delyamio/Avior/Алгоритм/use case общее.pdf

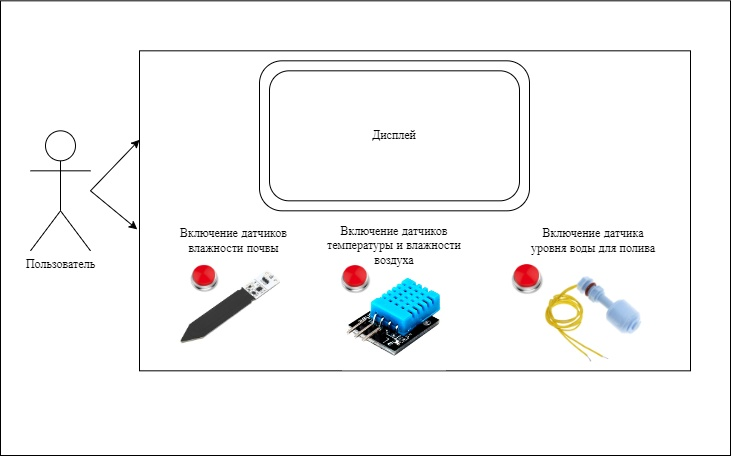
[picture p1: page 1]
