delyamio/Avior/Алгоритм/use case.pdf

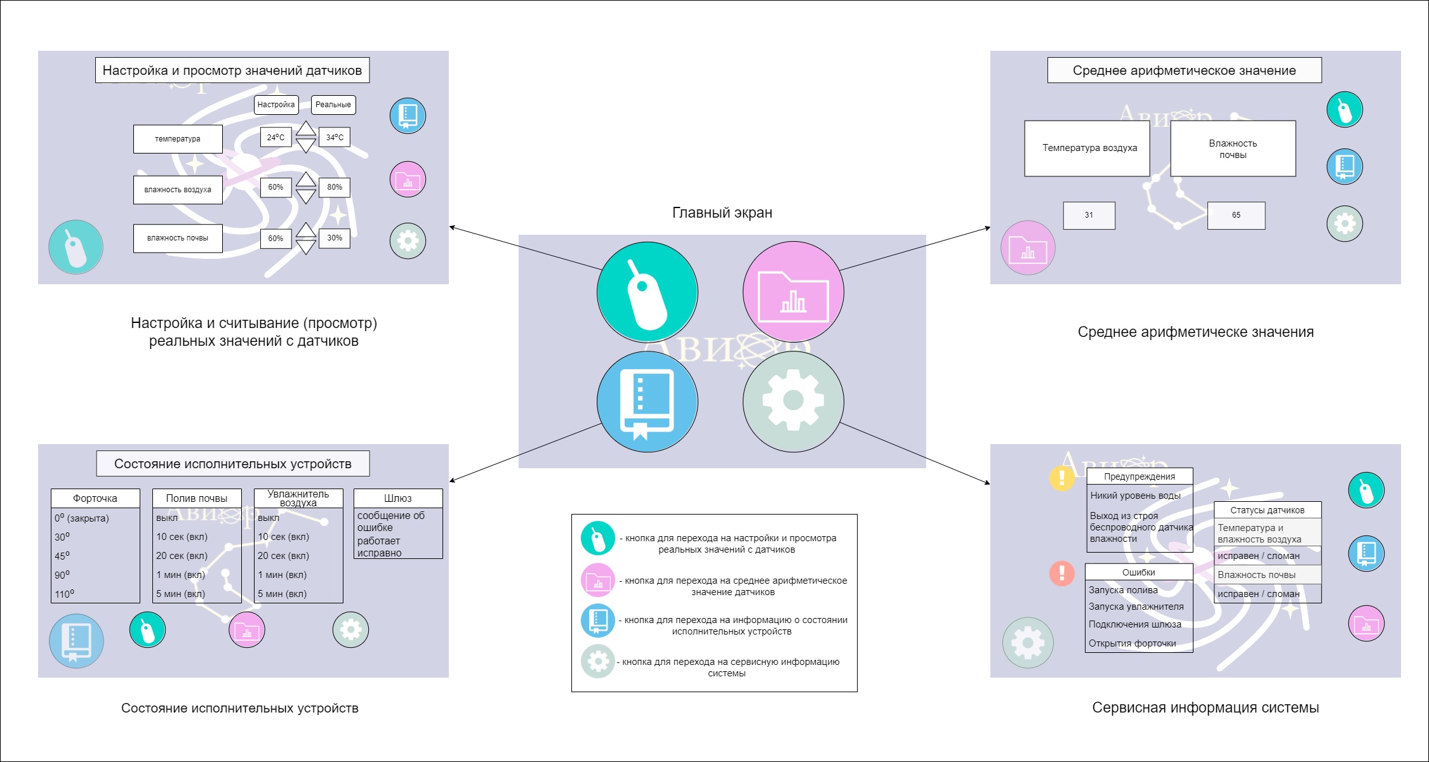
[picture p2: page 1]
