delyamio/Avior/Алгоритм/главный экран2.pdf

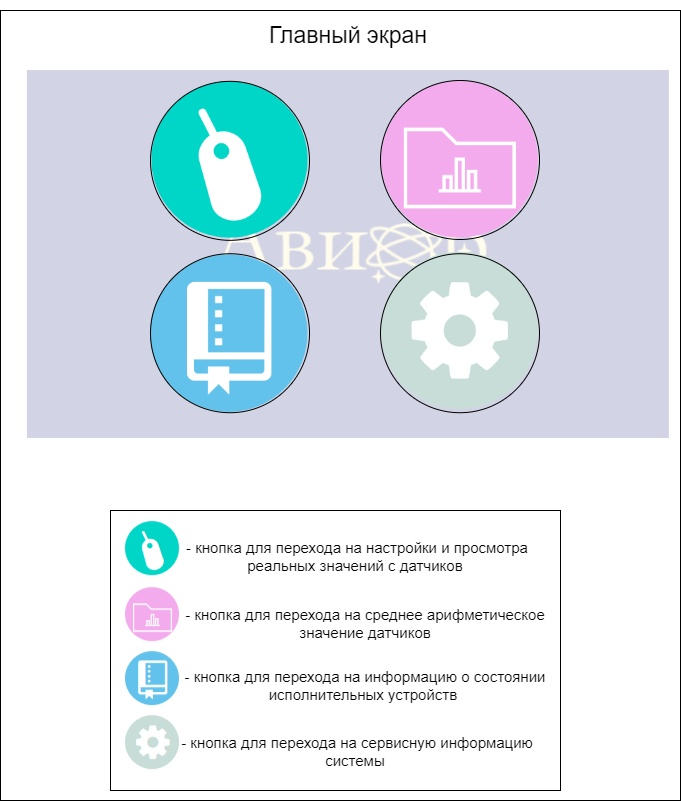
[picture p3: page 1]
