delyamio/Avior/Алгоритм/настройка значений.pdf

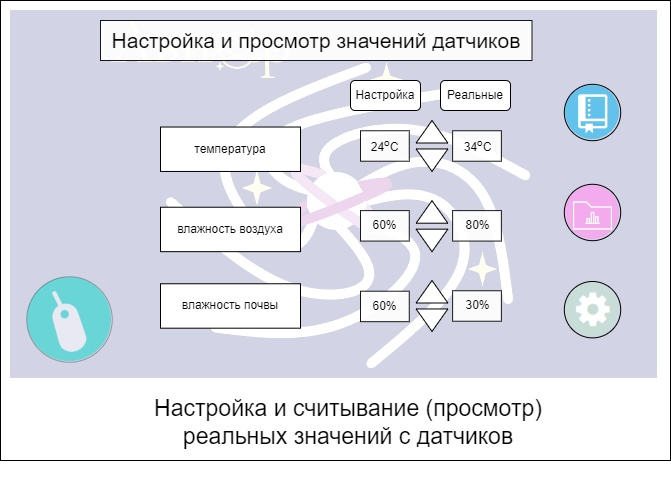
[picture p4: page 1]
