delyamio/Avior/Алгоритм/сервисная информайия.pdf

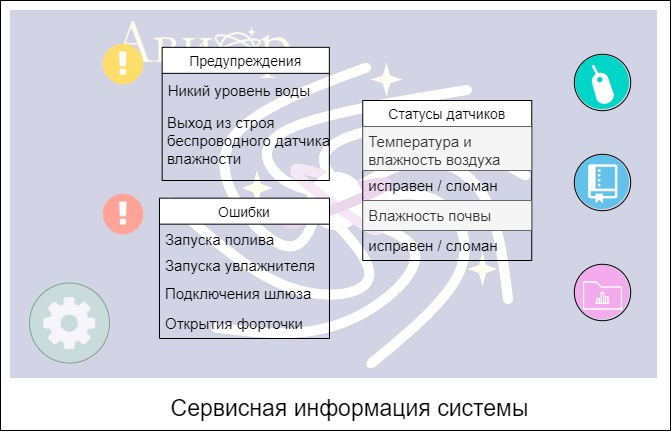
[picture p5: page 1]
