delyamio/Avior/Алгоритм/Состояние исполнительных устройств.pdf

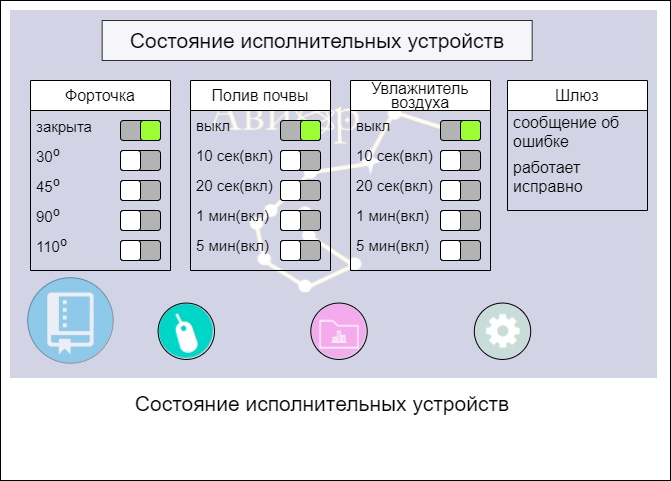
[picture p6: page 1]
