delyamio/Avior/Алгоритм/среднее арифметическое.pdf

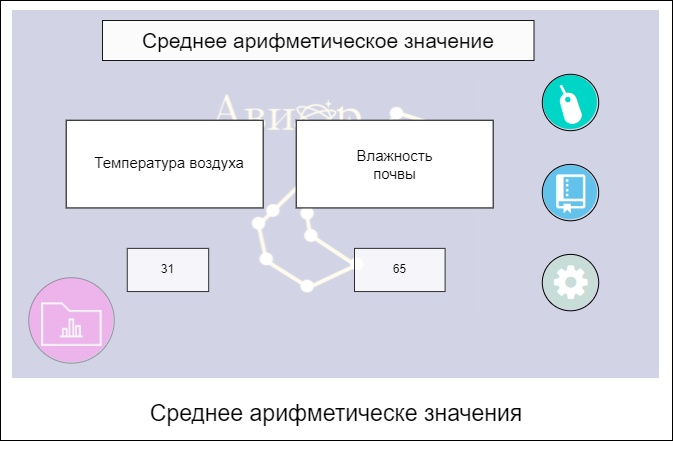
[picture p7: page 1]
