delyamio/Avior/Электроника/Монтажная схема - Механизм для форточки.pdf

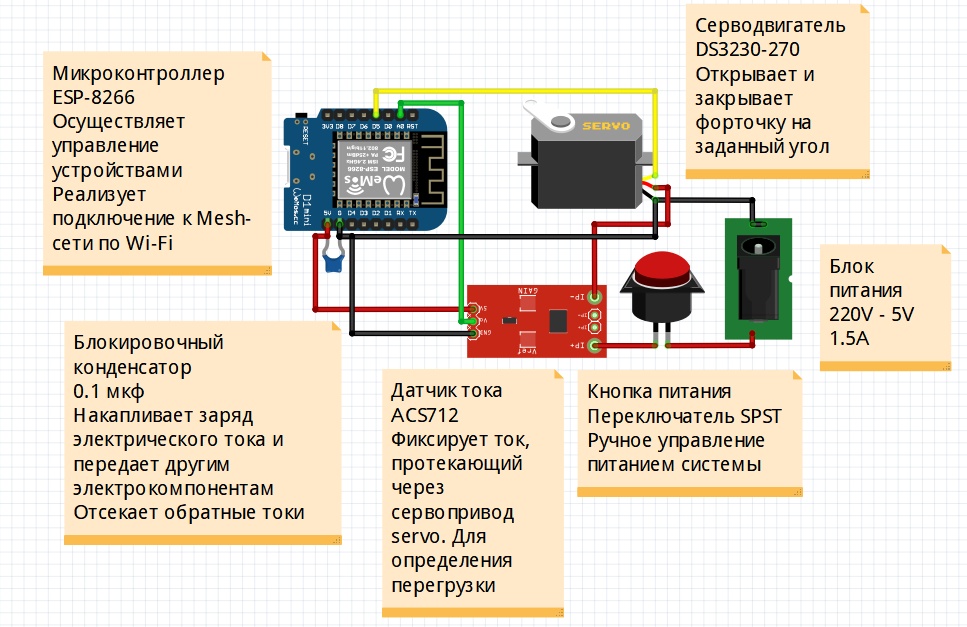
[picture p8: page 1]
