delyamio/Avior/Электроника/Монтажная схема - Система климатических датчиков.pdf

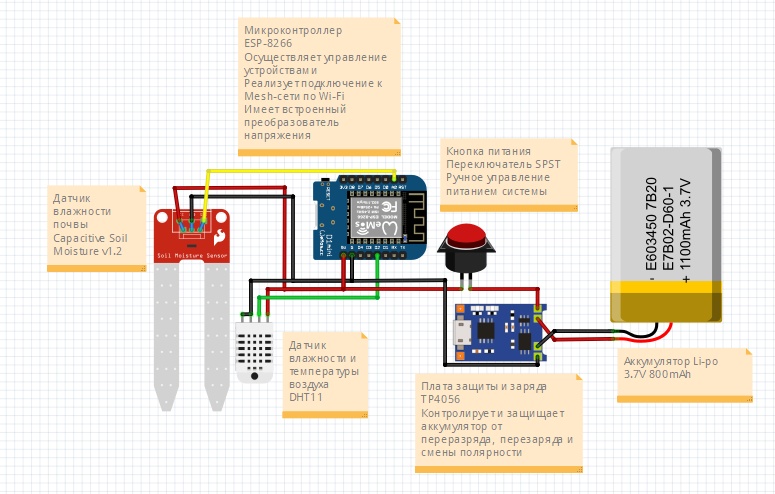
[picture p9: page 1]
