delyamio/Avior/Электроника/Монтажная схема - Система полива и увлажнения.pdf

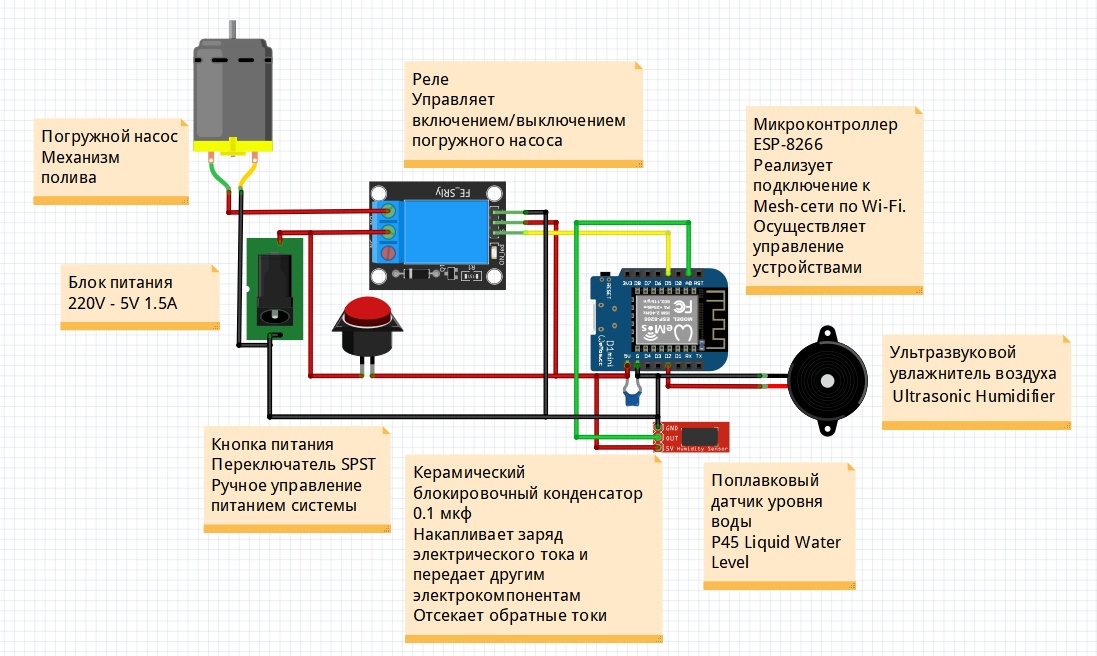
[picture p10: page 1]
