delyamio/Avior/Электроника/Монтажная схема - Узел агрегации.pdf

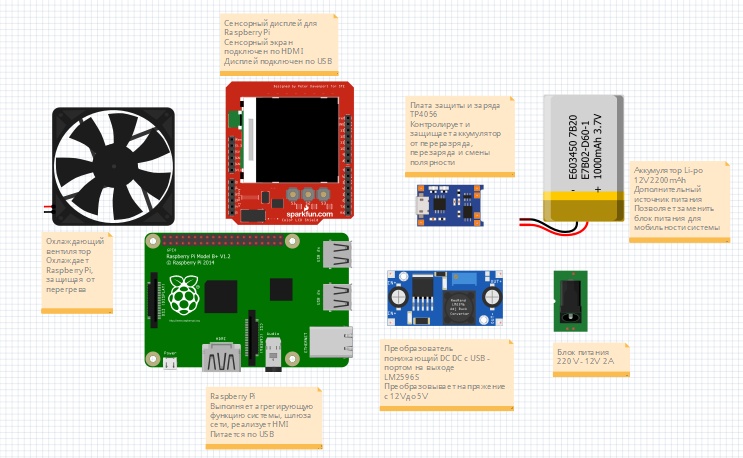
[picture p11: page 1]
