delyamio/Avior/Электроника/Принципиальная схема - Механизм для форточки.pdf

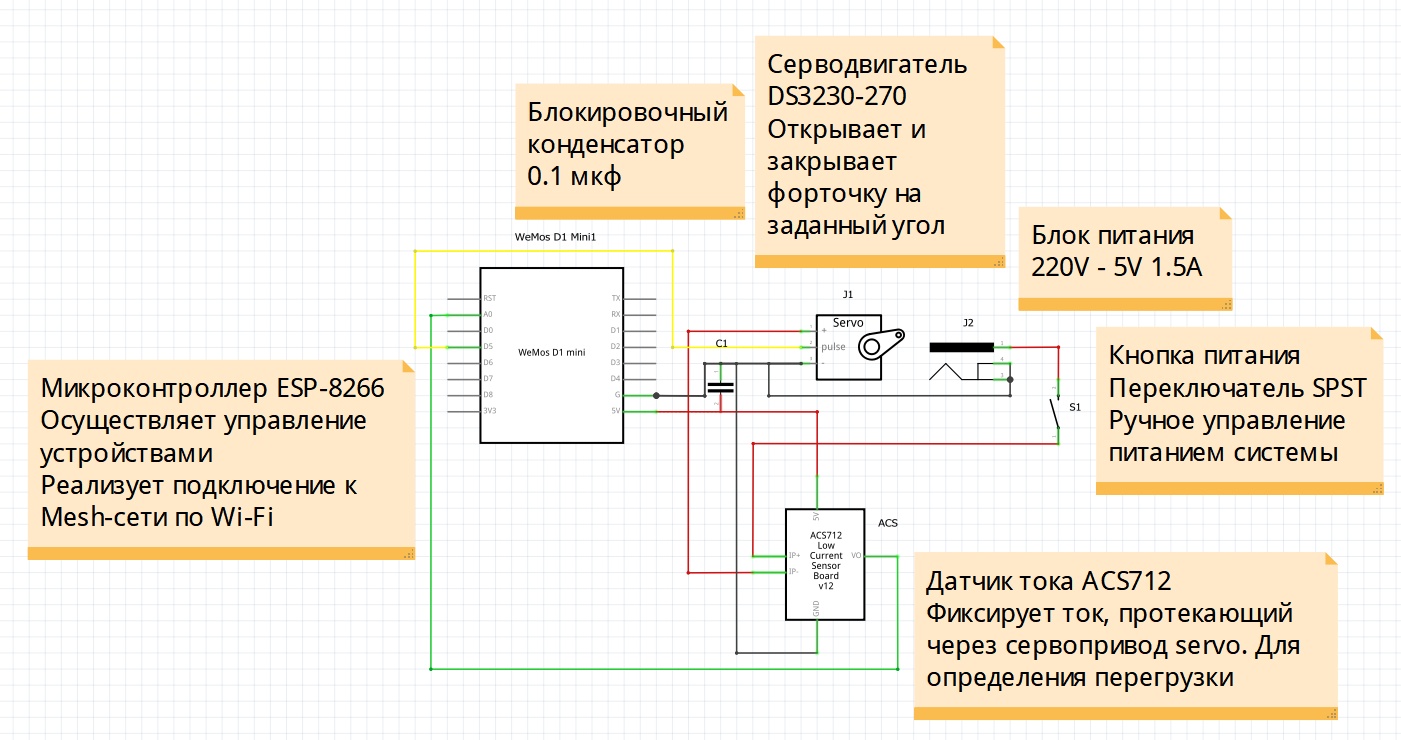
[picture p12: page 1]
