delyamio/Avior/Электроника/Принципиальная схема - Система климатических датчиков.pdf

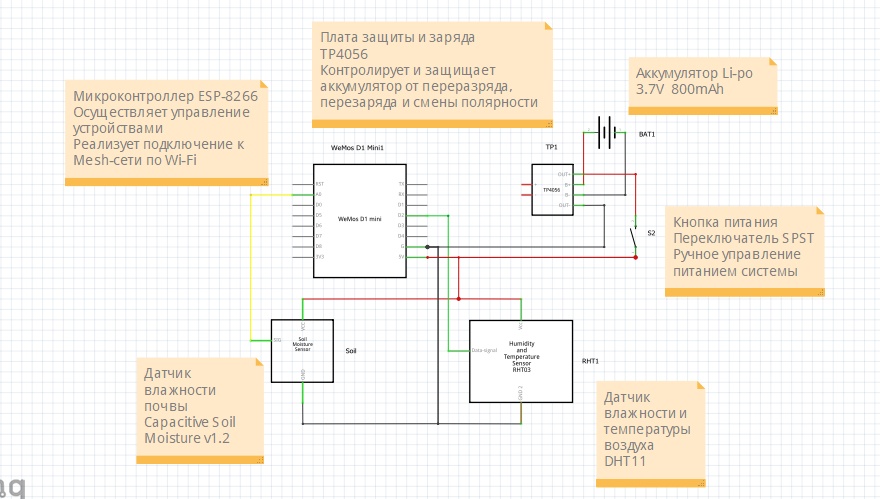
[picture p13: page 1]
