delyamio/Avior/Электроника/Принципиальная схема - Система полива и увлажнения.pdf

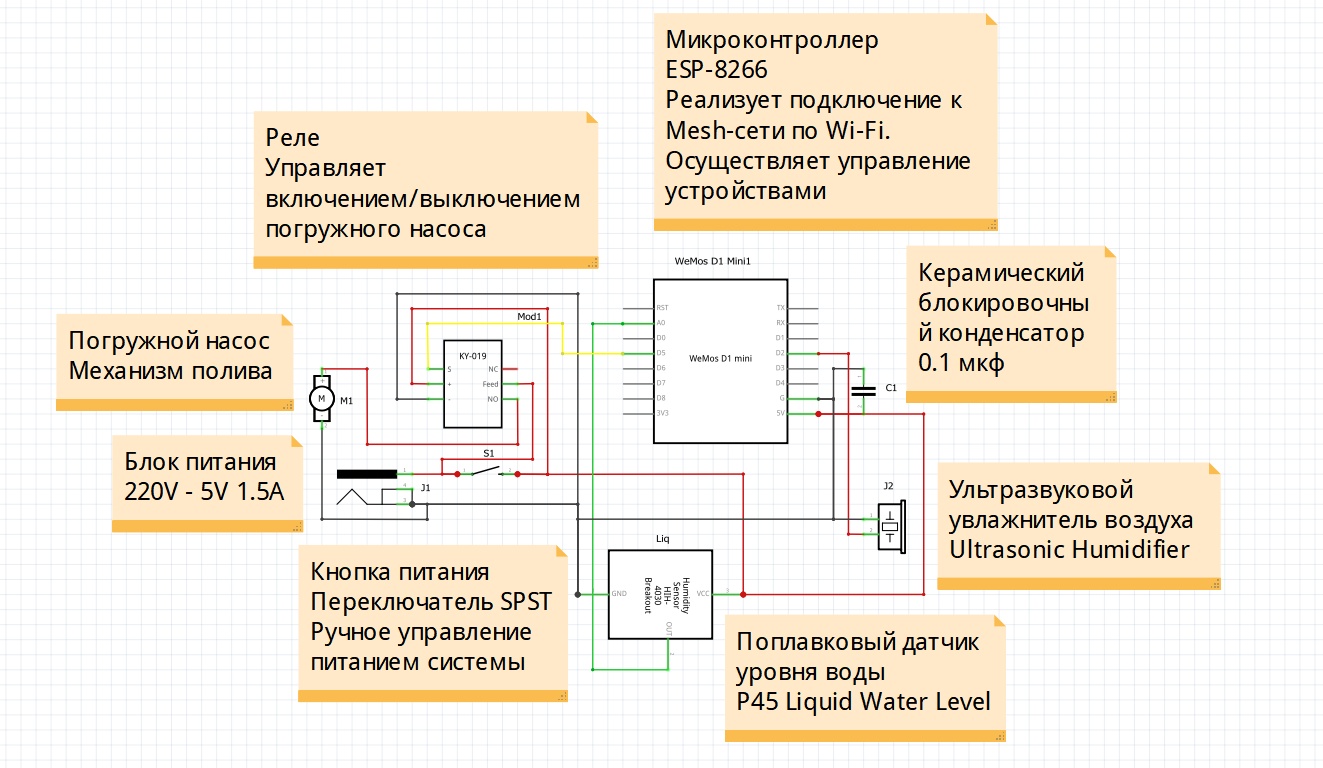
[picture p14: page 1]
