delyamio/Avior/Электроника/Принципиальная схема - Узел агрегации.pdf

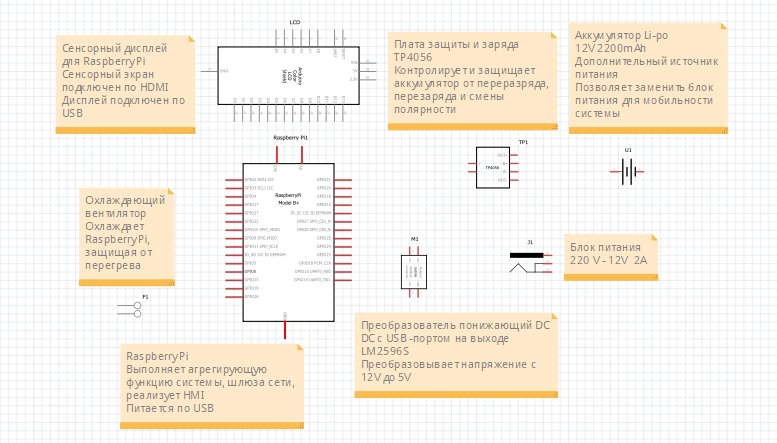
[picture p15: page 1]
