delyamio/Avior/3D модели/рендеринг/датчики воздух почва/датчики воздух почва 2.png

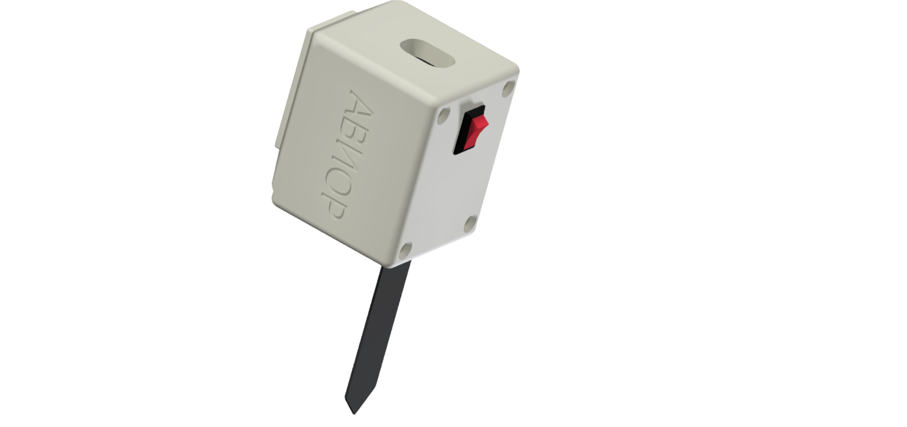
3D модели/рендеринг/датчики воздух почва/датчики воздух почва 2.png
