delyamio/Avior/3D модели/рендеринг/датчики воздух почва/датчики воздух почва.png

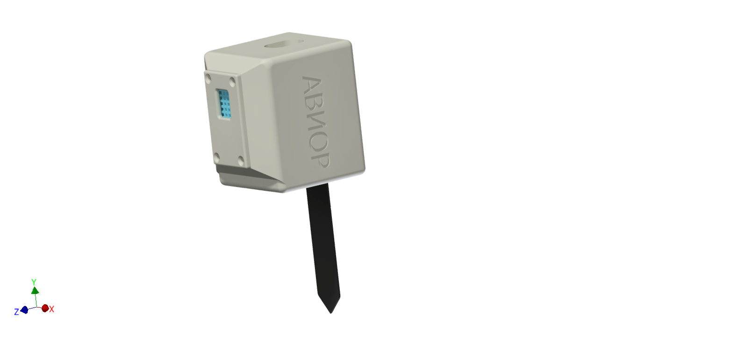
3D модели/рендеринг/датчики воздух почва/датчики воздух почва.png
