delyamio/Avior/3D модели/рендеринг/датчики воздух почва/датчики.png

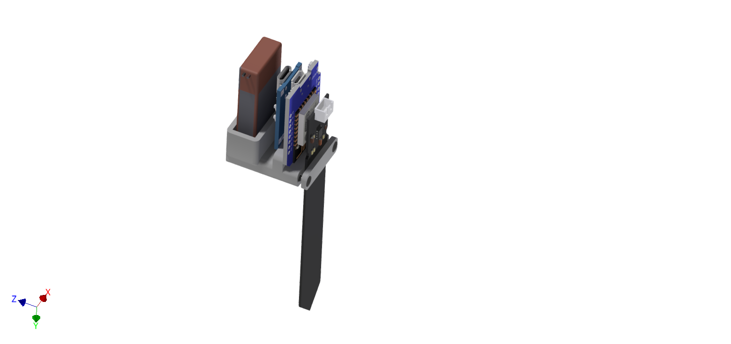
3D модели/рендеринг/датчики воздух почва/датчики.png
