delyamio/Avior/3D модели/рендеринг/датчики воздух почва/корпус датчики1.png

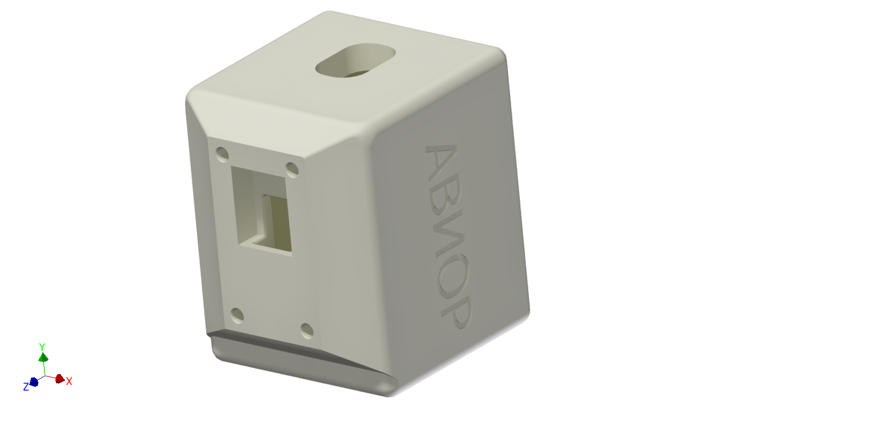
3D модели/рендеринг/датчики воздух почва/корпус датчики1.png
