delyamio/Avior/3D модели/рендеринг/датчики воздух почва/корпус датчики 2.png

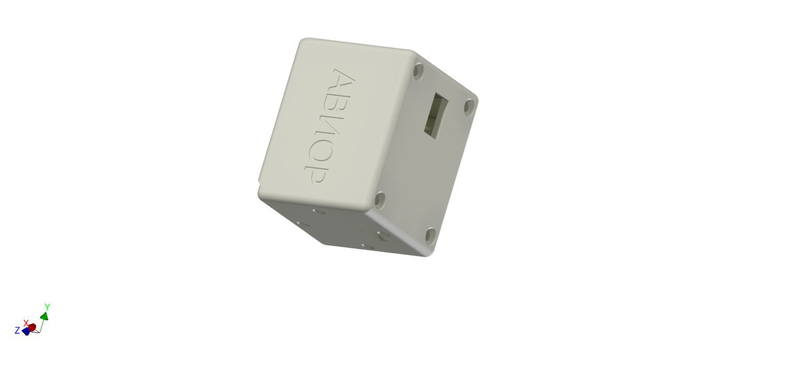
3D модели/рендеринг/датчики воздух почва/корпус датчики 2.png
