delyamio/Avior/3D модели/рендеринг/Дисплей/компоновка корпус дисплей.png

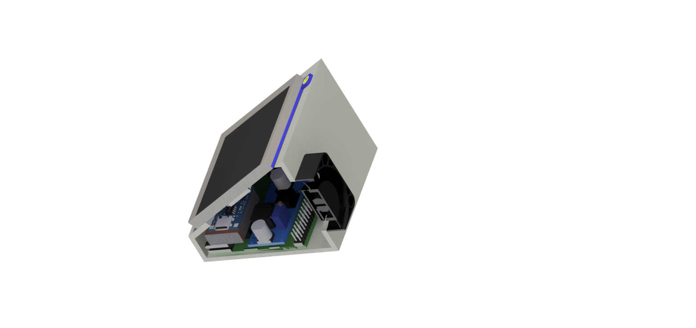
3D модели/рендеринг/Дисплей/компоновка корпус дисплей.png
