delyamio/Avior/3D модели/рендеринг/Дисплей/корпус дисплей.png

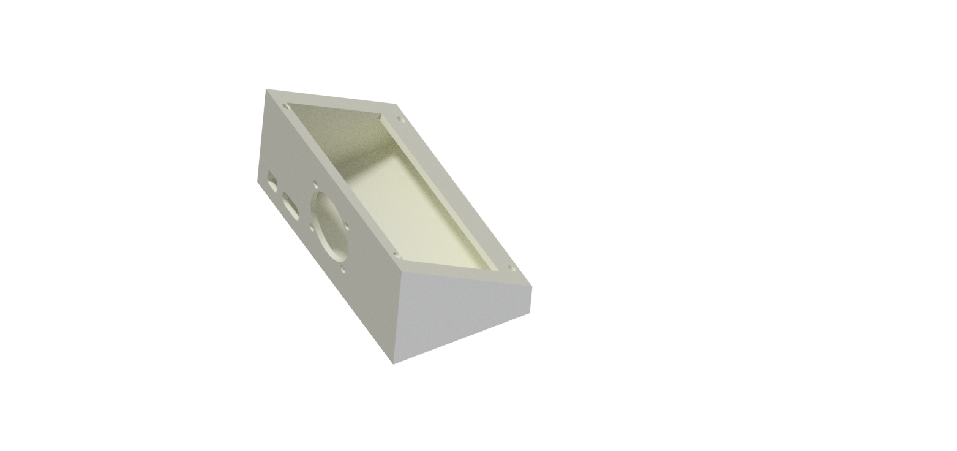
3D модели/рендеринг/Дисплей/корпус дисплей.png
