delyamio/Avior/3D модели/рендеринг/емкость/держатель.png

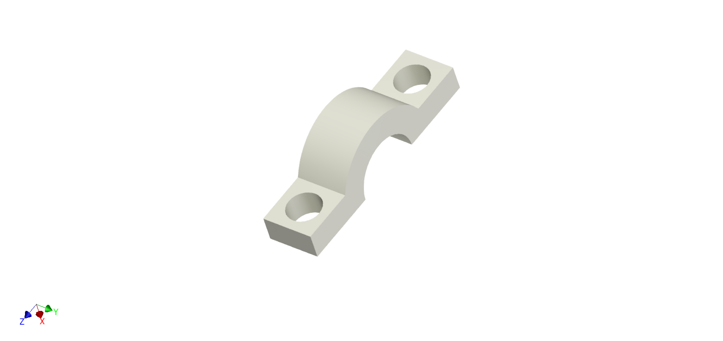
3D модели/рендеринг/емкость/держатель.png
