delyamio/Avior/3D модели/рендеринг/емкость/компоновка емкость.png

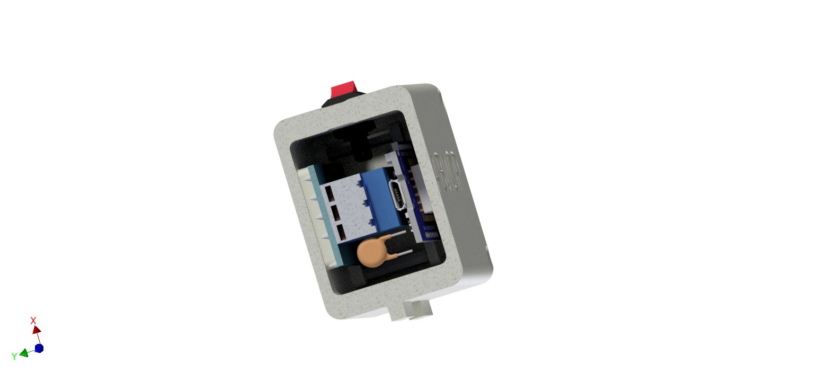
3D модели/рендеринг/емкость/компоновка емкость.png
