delyamio/Avior/3D модели/рендеринг/емкость/корпус емкость.png

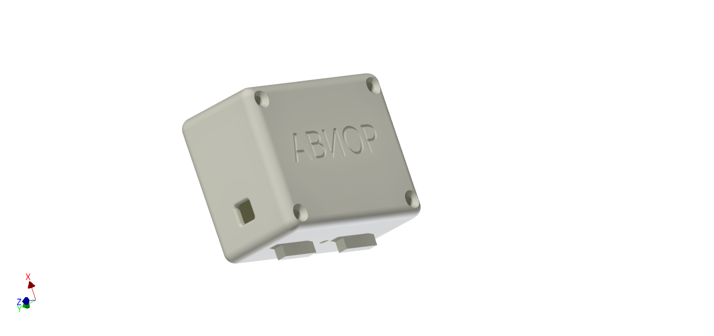
3D модели/рендеринг/емкость/корпус емкость.png
