delyamio/Avior/3D модели/рендеринг/емкость/соединитель 1.png

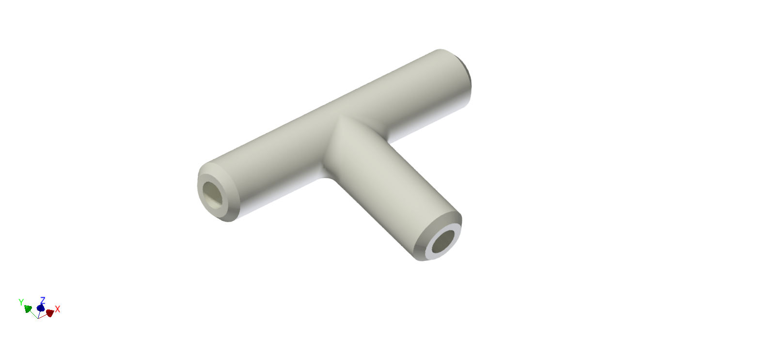
3D модели/рендеринг/емкость/соединитель 1.png
