delyamio/Avior/3D модели/рендеринг/емкость/сосуд.png

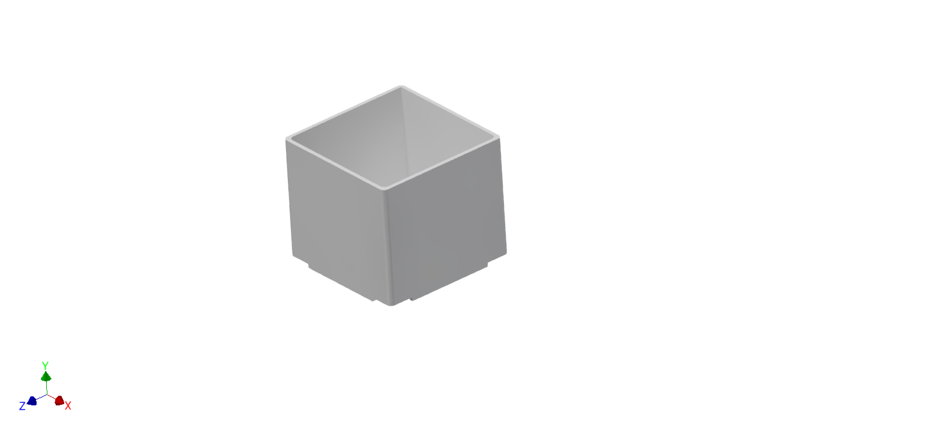
3D модели/рендеринг/емкость/сосуд.png
