delyamio/Avior/3D модели/рендеринг/емкость/труба 3.png

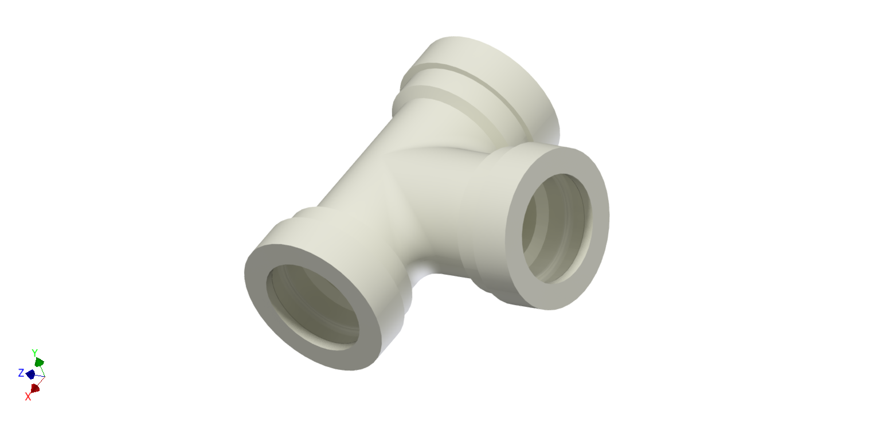
3D модели/рендеринг/емкость/труба 3.png
