delyamio/Avior/3D модели/рендеринг/емкость/УвлажнительНовый.png

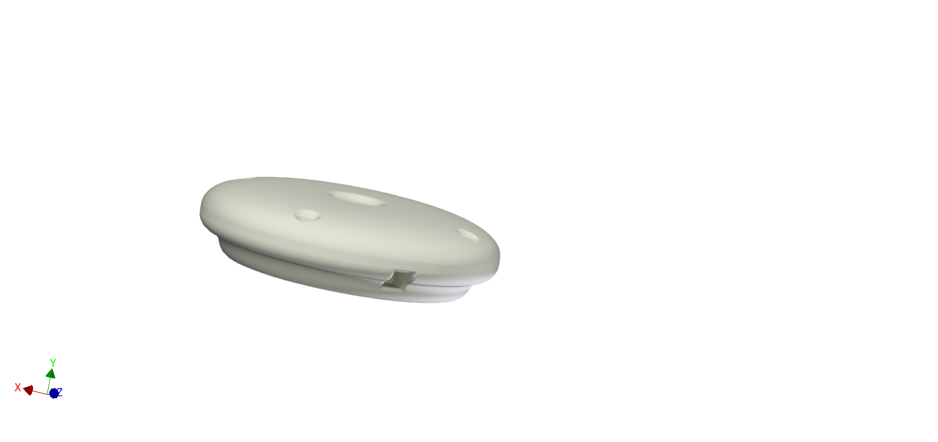
3D модели/рендеринг/емкость/УвлажнительНовый.png
