delyamio/Avior/3D модели/рендеринг/основание/основание.png

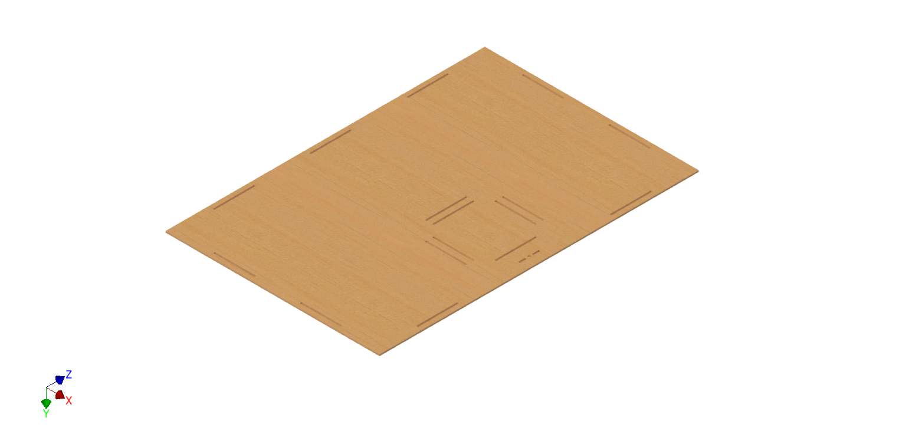
3D модели/рендеринг/основание/основание.png
