delyamio/Avior/3D модели/рендеринг/основание/сборка основание.png

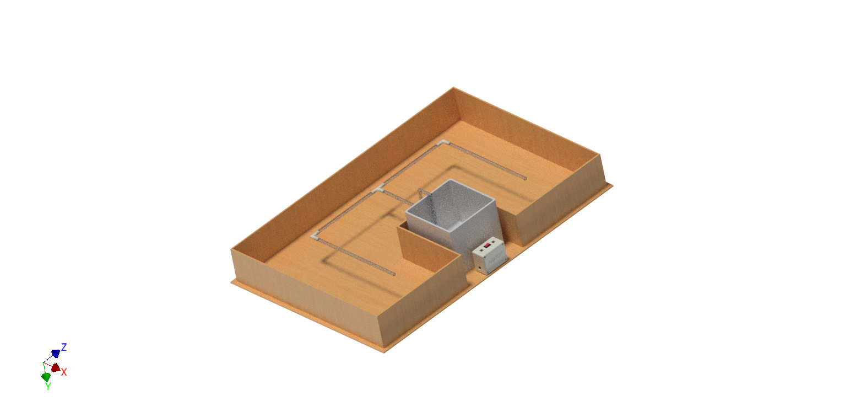
3D модели/рендеринг/основание/сборка основание.png
