delyamio/Avior/3D модели/рендеринг/основание/стенка.png

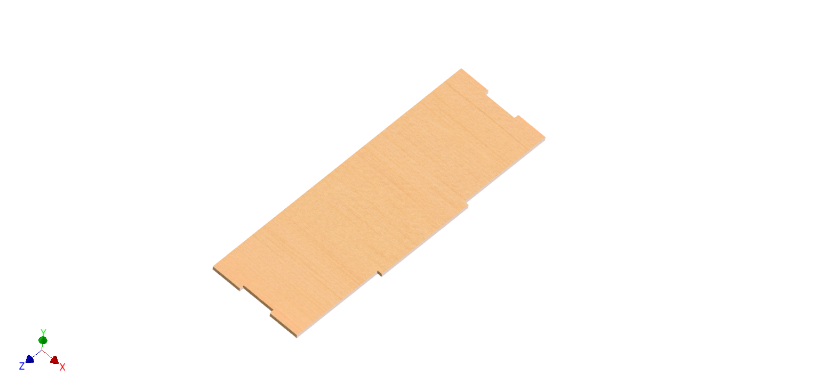
3D модели/рендеринг/основание/стенка.png
