delyamio/Avior/3D модели/рендеринг/финальная сборка1.png

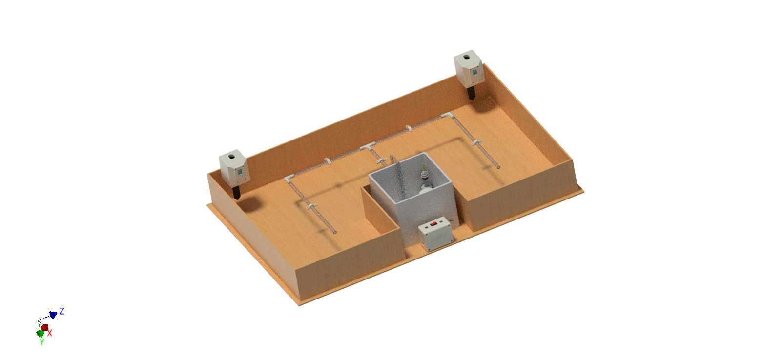
3D модели/рендеринг/финальная сборка1.png
