delyamio/Avior/3D модели/рендеринг/форточка/Кинематика.png

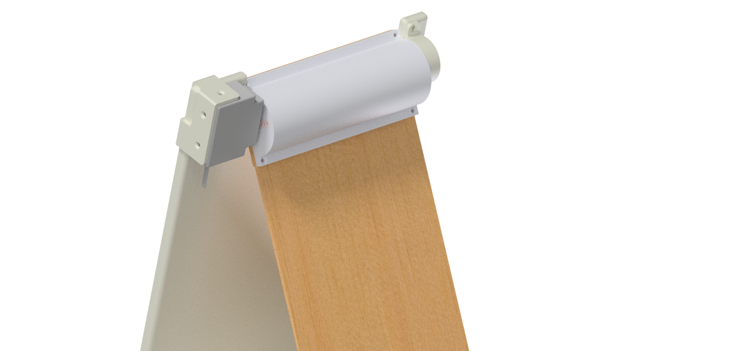
3D модели/рендеринг/форточка/Кинематика.png
