delyamio/Avior/3D модели/рендеринг/форточка/механизм управления форточкой.png

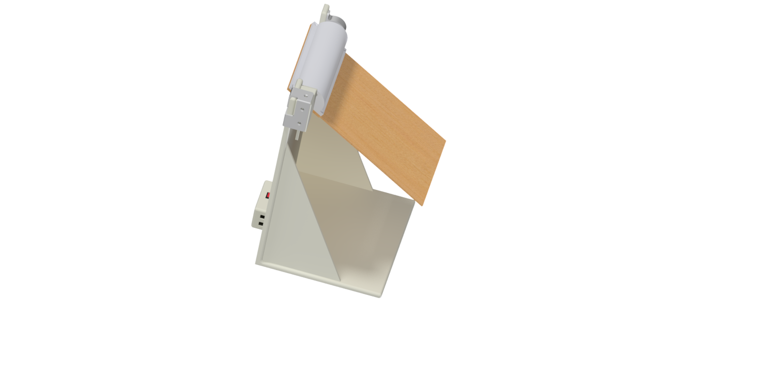
3D модели/рендеринг/форточка/механизм управления форточкой.png
