delyamio/Avior/3D модели/Детали step/Датчики воздух почва/DHT11.stp

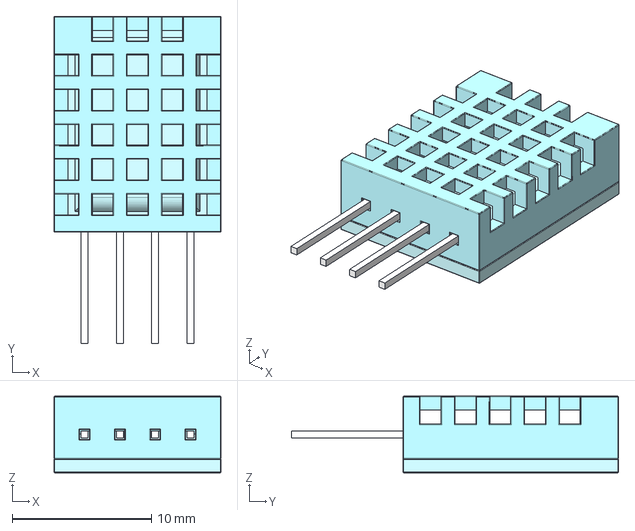
[picture p36: CAD file, 2023-02-20]
3D модели/Детали step/Датчики воздух почва/DHT11.stp
12.0 x 23.5 x 5.50 mm
