delyamio/Avior/3D модели/Детали step/Дисплей/корпус.stp

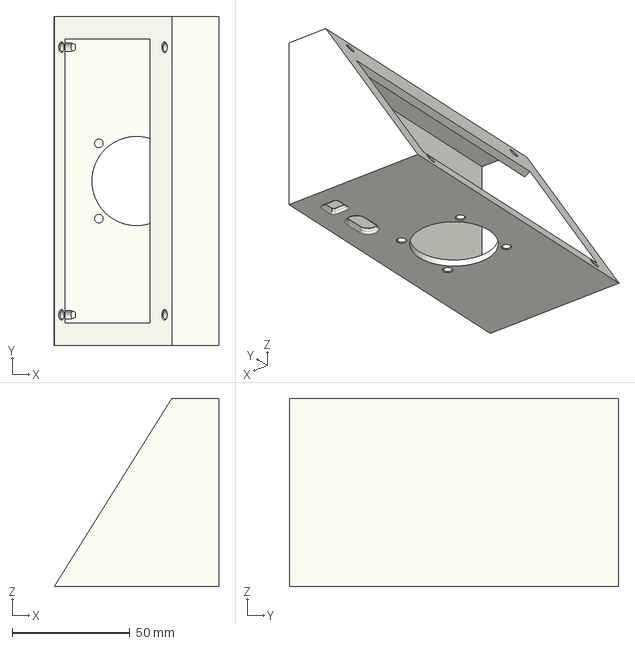
[picture p37: CAD file, 2023-02-20]
3D модели/Детали step/Дисплей/корпус.stp
70.0 x 140.0 x 80.0 mm
