delyamio/Avior/3D модели/Детали step/Емкость/шланг передний.stp

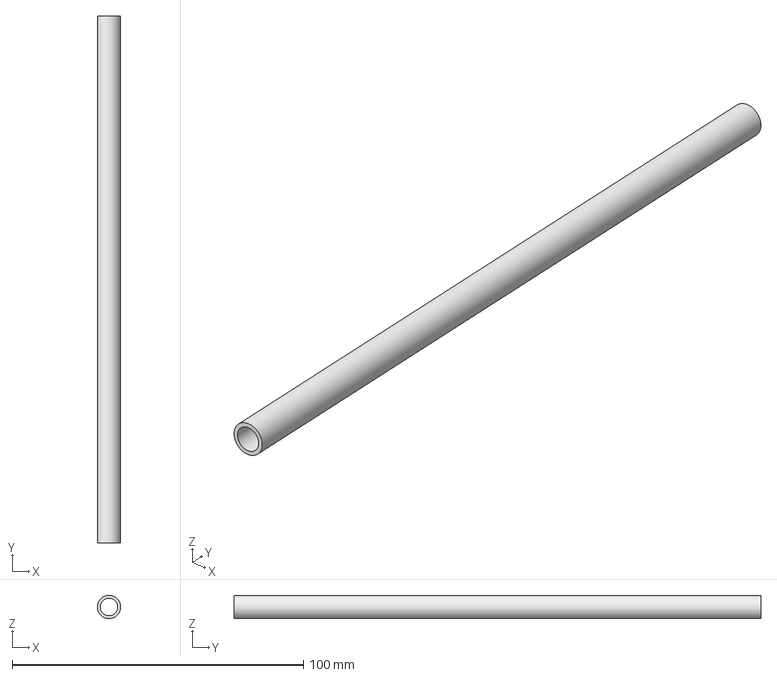
[picture p38: CAD file, 2023-02-20]
3D модели/Детали step/Емкость/шланг передний.stp
8.00 x 181.0 x 8.00 mm
