delyamio/Avior/3D модели/Детали step/Основание/стенка 2.stp

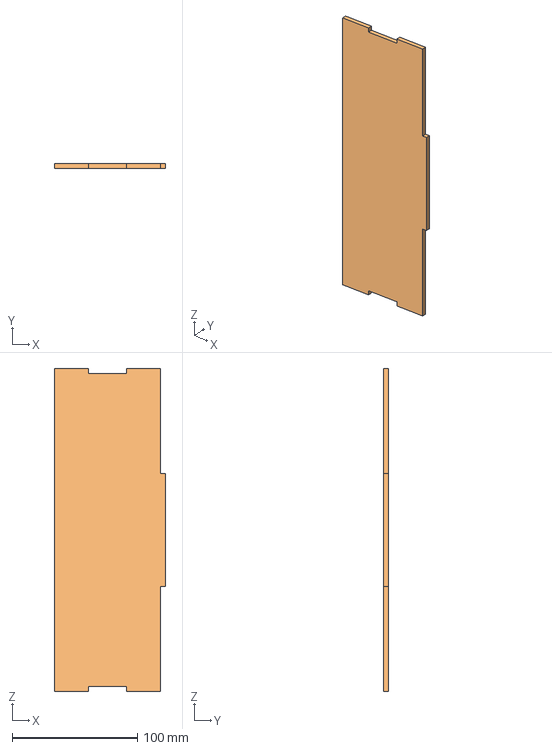
[picture p39: CAD file, 2023-02-20]
3D модели/Детали step/Основание/стенка 2.stp
89.0 x 4.00 x 258.0 mm
