delyamio/Avior/3D модели/Детали step/Форточка/корпус подшипник.stp

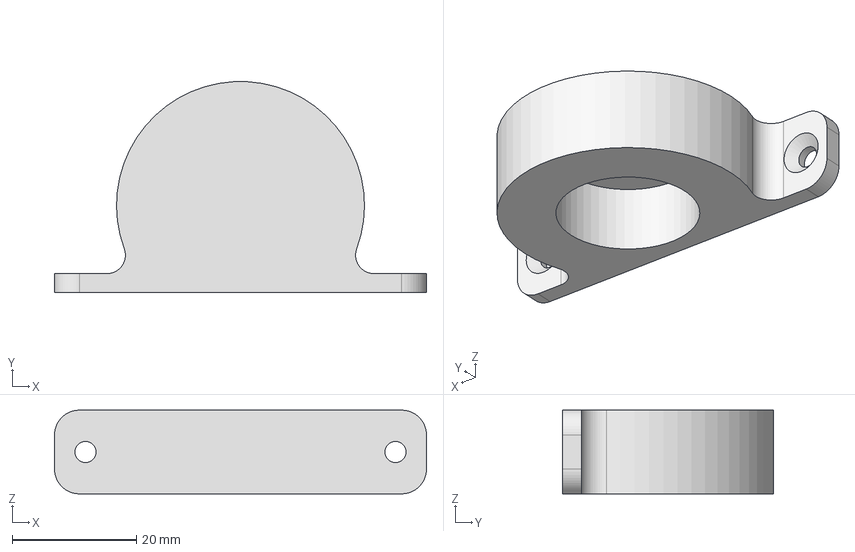
[picture p40: CAD file, 2023-02-20]
3D модели/Детали step/Форточка/корпус подшипник.stp
60.0 x 34.0 x 13.5 mm
