delyamio/Avior/3D модели/Сборки step/Форточка/коробка + сервак.stp

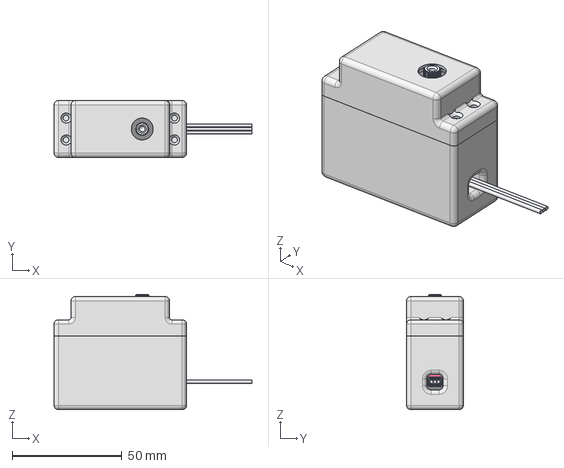
[picture p41: CAD file, 2023-02-20]
3D модели/Сборки step/Форточка/коробка + сервак.stp
90.4 x 26.0 x 52.6 mm
коробка сервак
сервопривод
