delyamio/Avior/3D модели/Детали step/Датчики воздух почва/Пластина.stp

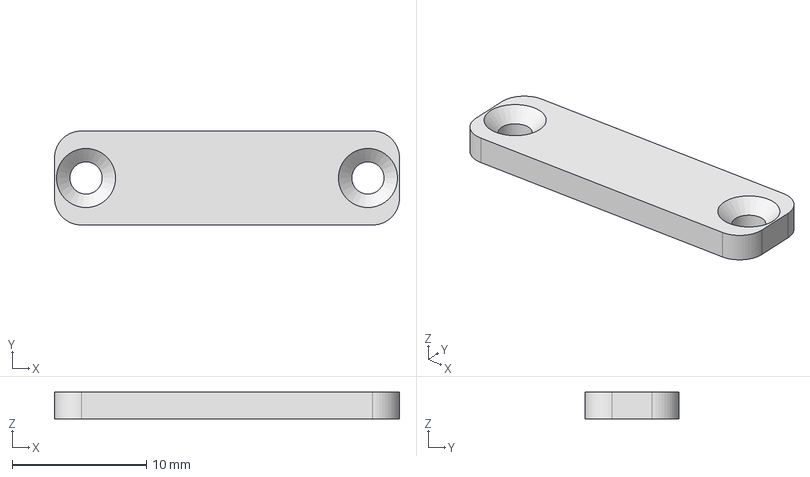
[picture p42: CAD file, 2023-02-20]
3D модели/Детали step/Датчики воздух почва/Пластина.stp
25.7 x 7.00 x 2.00 mm
