delyamio/Avior/3D модели/Детали step/Емкость/труба 3.stp

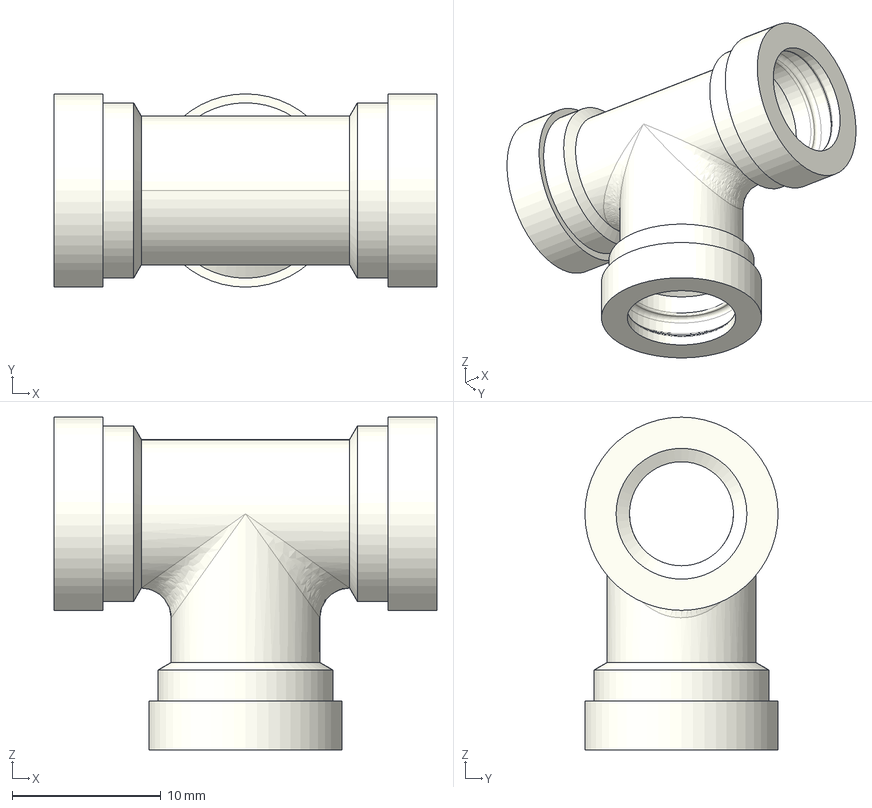
[picture p43: CAD file, 2023-02-20]
3D модели/Детали step/Емкость/труба 3.stp
25.8 x 13.0 x 22.4 mm
