delyamio/Avior/3D модели/Детали step/Основание/стенка боковая.stp

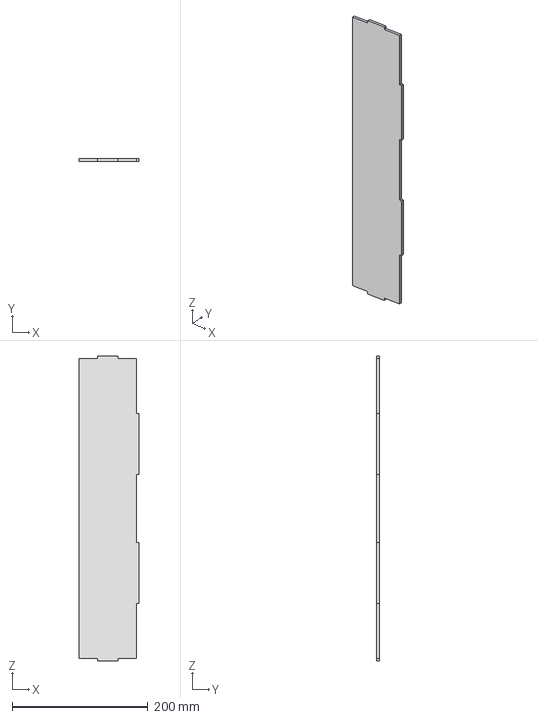
[picture p44: CAD file, 2023-02-20]
3D модели/Детали step/Основание/стенка боковая.stp
89.0 x 4.00 x 450.0 mm
