delyamio/Avior/3D модели/Детали step/Форточка/кронштейн.stp

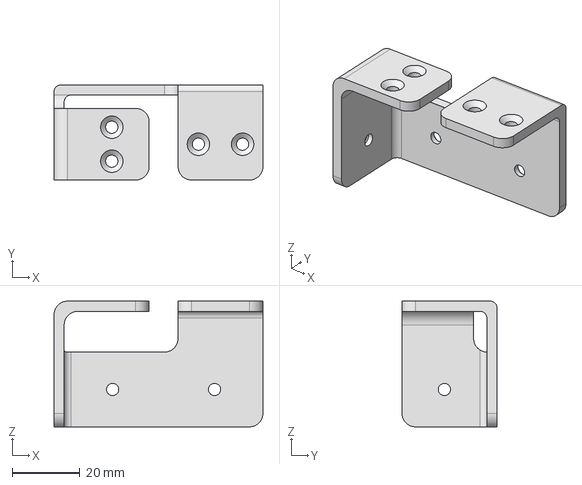
[picture p45: CAD file, 2023-02-20]
3D модели/Детали step/Форточка/кронштейн.stp
61.5 x 28.0 x 37.0 mm
