delyamio/Avior/3D модели/Сборки step/Форточка/новая форточка.stp

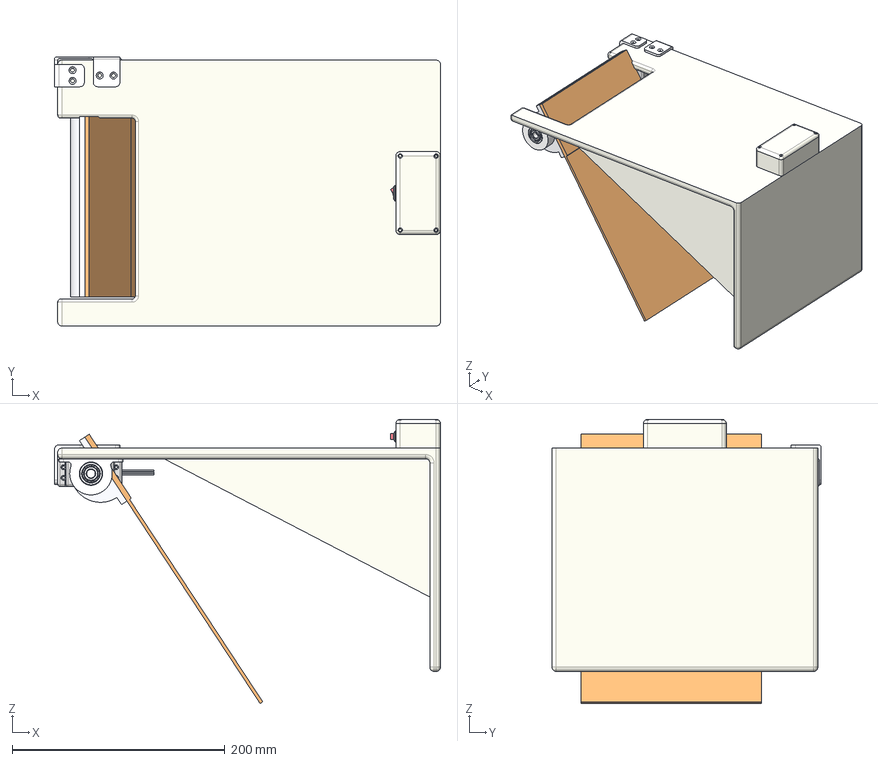
[picture p46: CAD file, 2023-02-20]
3D модели/Сборки step/Форточка/новая форточка.stp
363.0 x 253.0 x 267.2 mm
основание форточки
servo arm
вал форточка
коробка сервак
сервопривод
корпус подшипник
кронштейн
подшипник
форточка
Switch on off
