delyamio/Avior/3D модели/Детали step/Датчики воздух почва/Кронштейн МК.stp

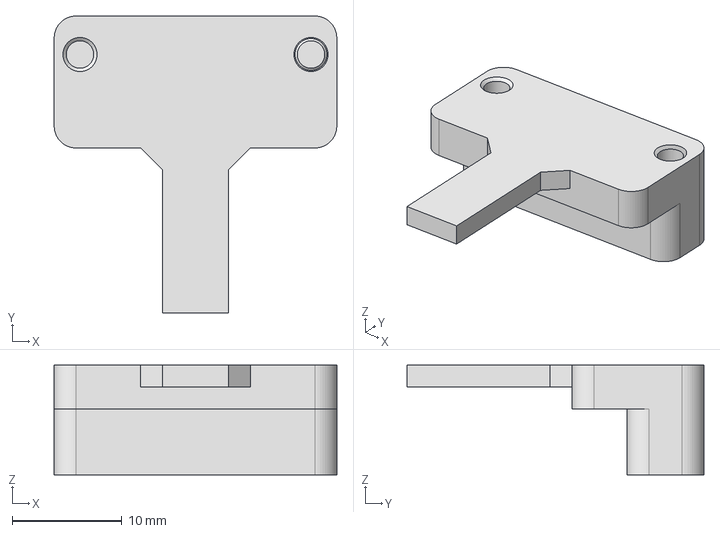
[picture p47: CAD file, 2023-02-20]
3D модели/Детали step/Датчики воздух почва/Кронштейн МК.stp
25.7 x 27.0 x 10.0 mm
