delyamio/Avior/3D модели/Детали step/Основание/основание.stp

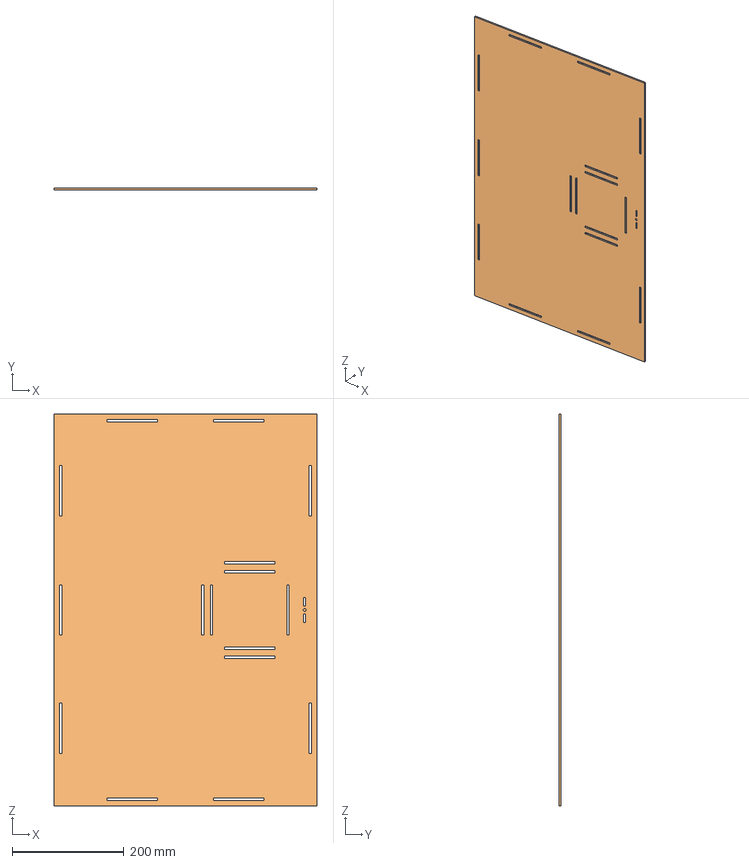
[picture p48: CAD file, 2023-02-20]
3D модели/Детали step/Основание/основание.stp
470.0 x 4.00 x 701.0 mm
