delyamio/Avior/3D модели/Детали step/Форточка/форточка.stp

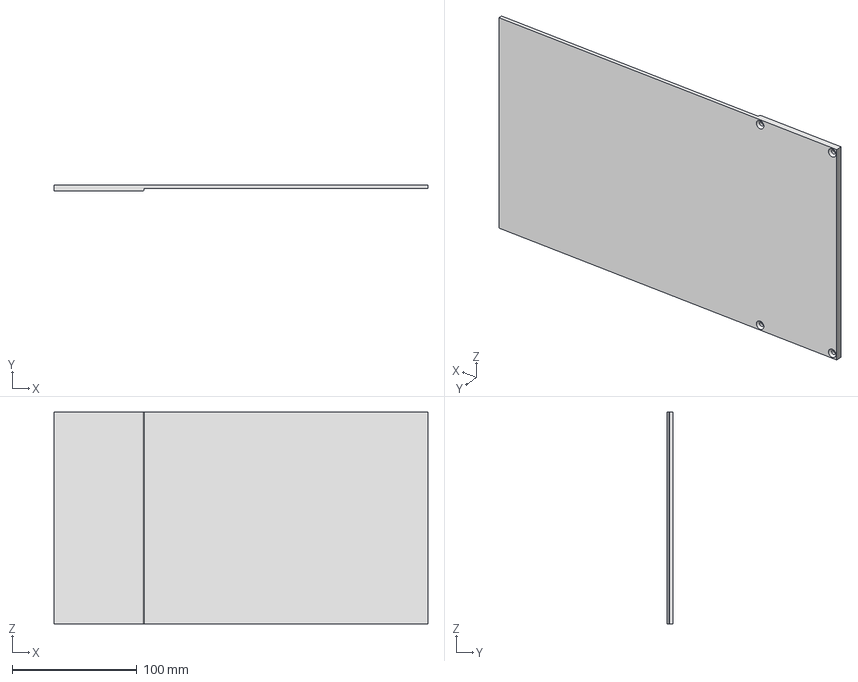
[picture p49: CAD file, 2023-02-20]
3D модели/Детали step/Форточка/форточка.stp
300.0 x 5.00 x 170.0 mm
