delyamio/Avior/3D модели/Детали step/Датчики воздух почва/Кронштейн АКБ.stp

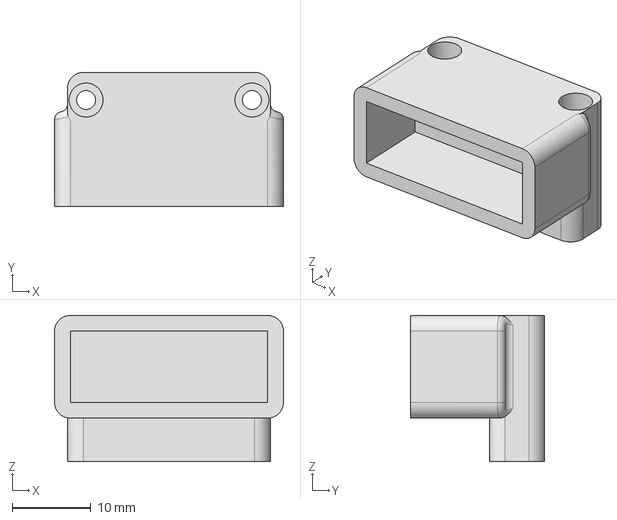
[picture p50: CAD file, 2023-02-20]
3D модели/Детали step/Датчики воздух почва/Кронштейн АКБ.stp
29.0 x 17.0 x 18.5 mm
