delyamio/Avior/3D модели/Детали step/Емкость/соединитель 2.stp

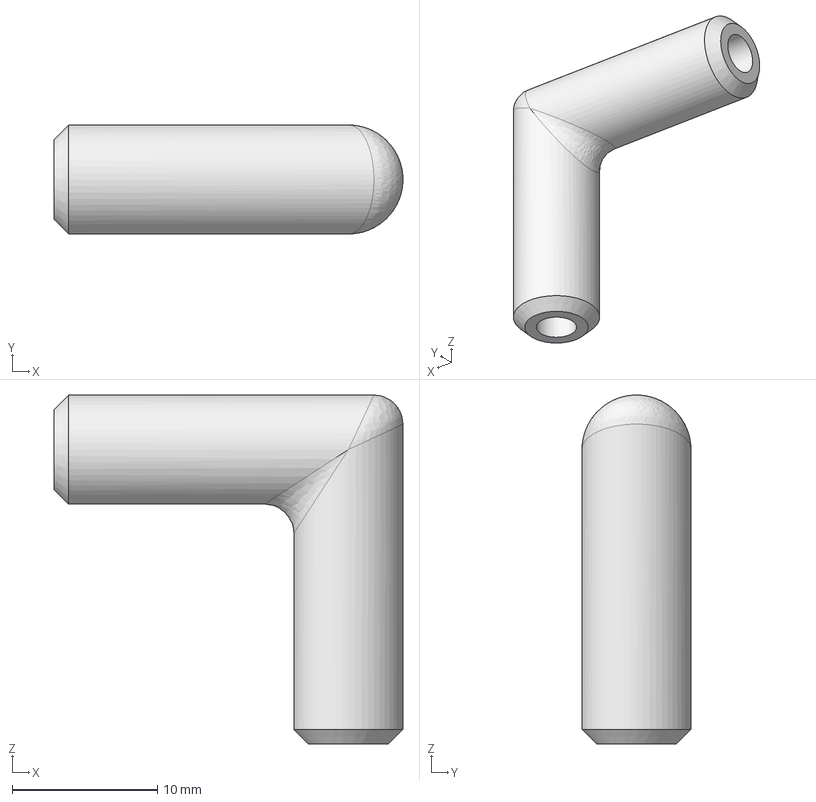
[picture p51: CAD file, 2023-02-20]
3D модели/Детали step/Емкость/соединитель 2.stp
24.0 x 7.50 x 24.0 mm
