delyamio/Avior/3D модели/Детали step/Основание/стенка 3.stp

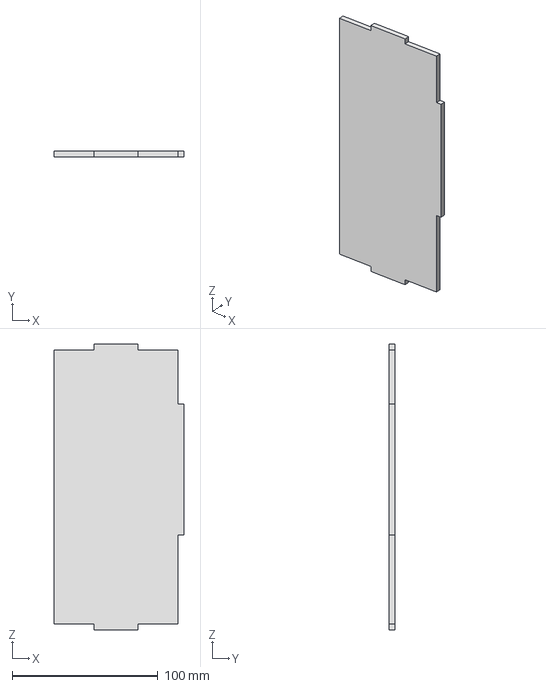
[picture p52: CAD file, 2023-02-20]
3D модели/Детали step/Основание/стенка 3.stp
89.0 x 4.00 x 196.0 mm
