delyamio/Avior/3D модели/Детали step/Форточка/подшипник.stp

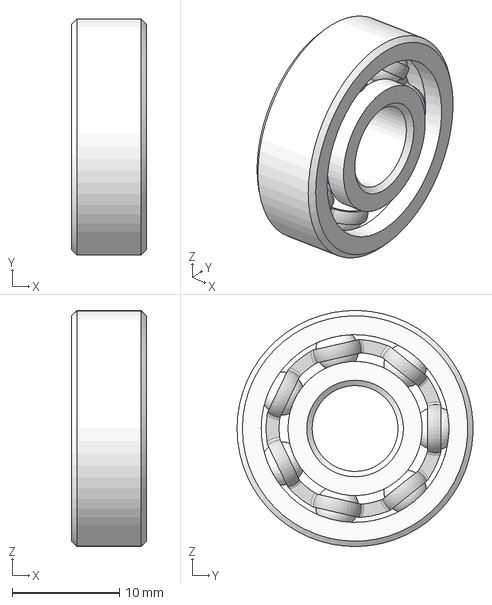
[picture p53: CAD file, 2023-02-20]
3D модели/Детали step/Форточка/подшипник.stp
7.00 x 22.0 x 22.0 mm
