delyamio/Avior/3D модели/Детали step/Датчики воздух почва/корпус.stp

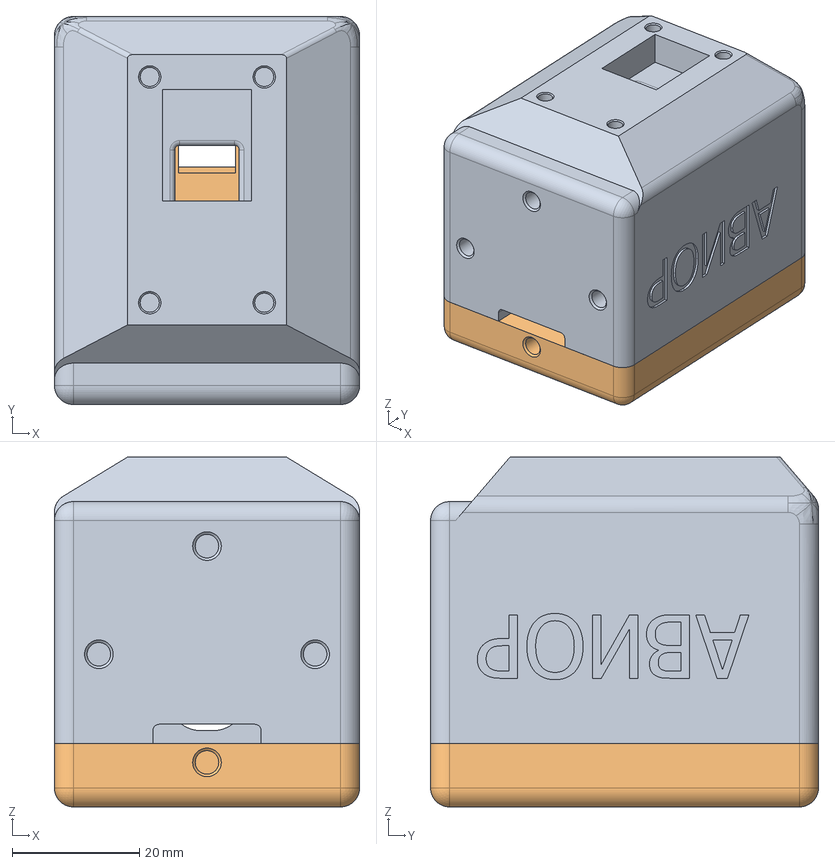
[picture p54: CAD file, 2023-02-20]
3D модели/Детали step/Датчики воздух почва/корпус.stp
48.0 x 61.0 x 55.0 mm
