delyamio/Avior/3D модели/Детали step/Емкость/УвлажнительНовый.stp

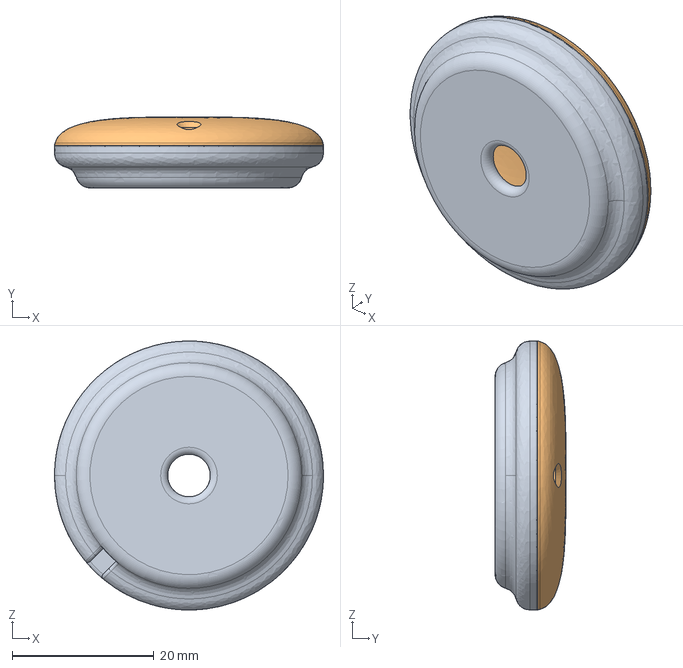
[picture p55: CAD file, 2023-02-20]
3D модели/Детали step/Емкость/УвлажнительНовый.stp
38.0 x 10.0 x 38.0 mm
