delyamio/Avior/3D модели/Детали step/Основание/стенка 1.stp

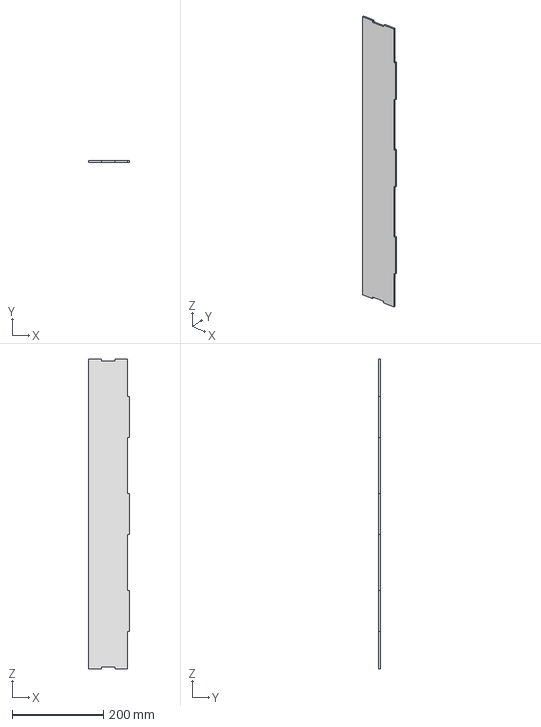
[picture p56: CAD file, 2023-02-20]
3D модели/Детали step/Основание/стенка 1.stp
89.0 x 4.00 x 681.0 mm
