delyamio/Avior/3D модели/Детали step/Форточка/сервопривод.stp

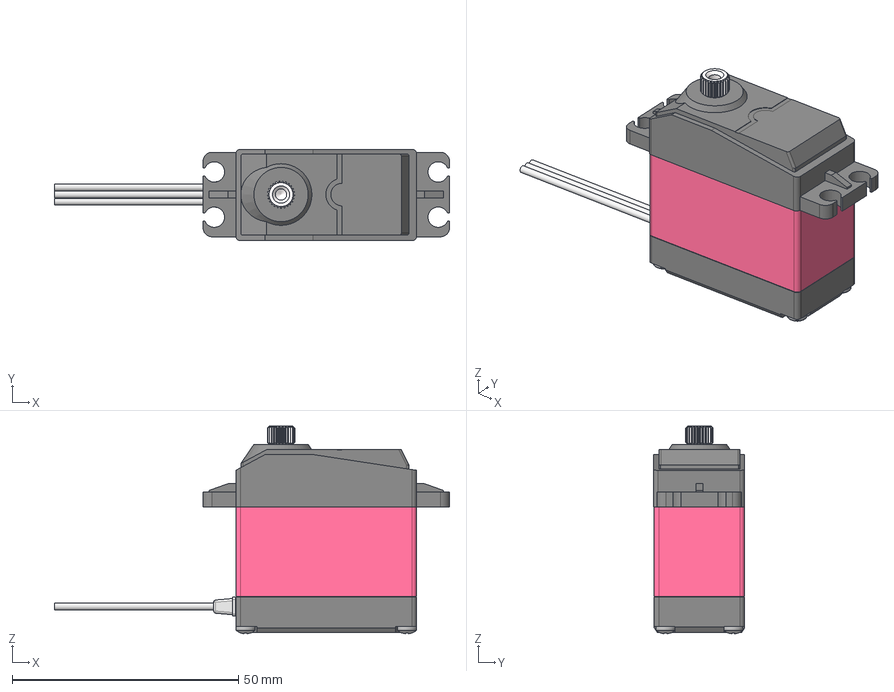
[picture p57: CAD file, 2023-02-20]
3D модели/Детали step/Форточка/сервопривод.stp
87.3 x 20.2 x 45.9 mm
