delyamio/Avior/3D модели/Детали step/Датчики воздух почва/крышка корпус.stp

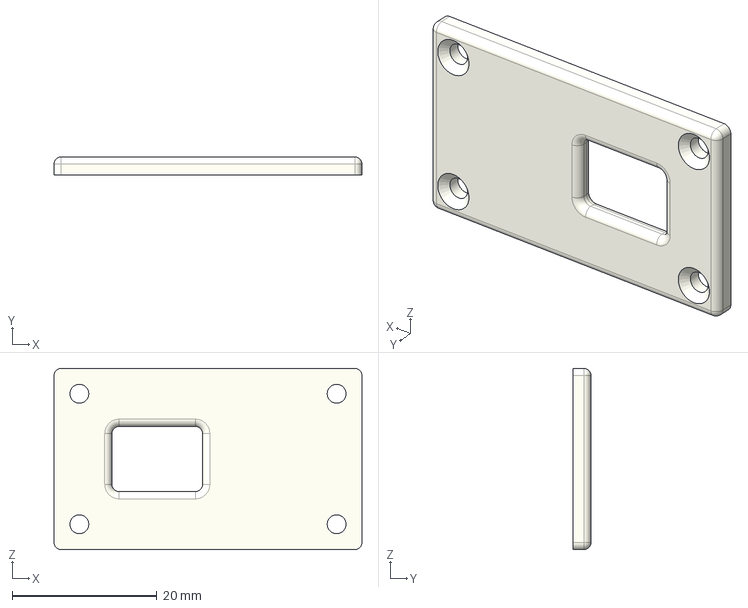
[picture p58: CAD file, 2023-02-20]
3D модели/Детали step/Датчики воздух почва/крышка корпус.stp
42.5 x 2.50 x 25.0 mm
