delyamio/Avior/3D модели/Детали step/Емкость/кронштейн wemos.stp

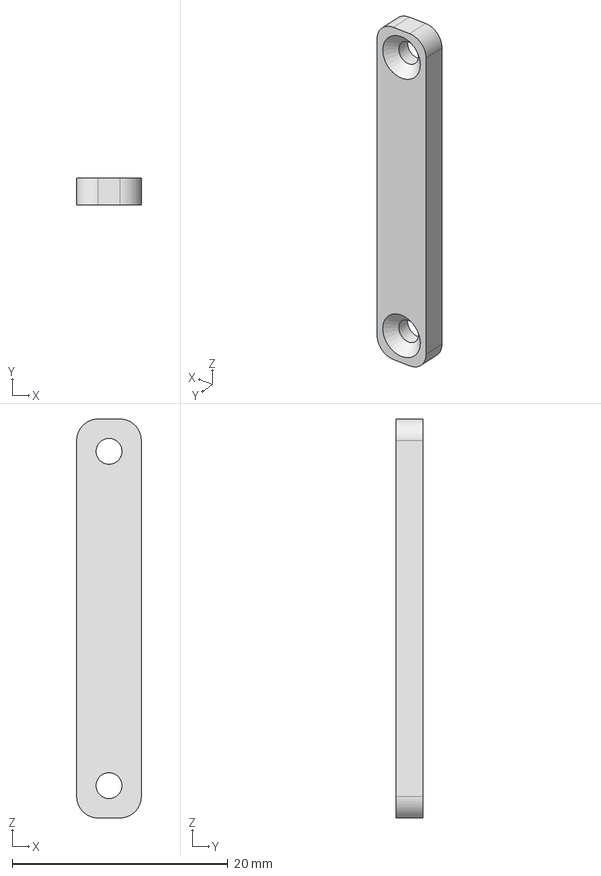
[picture p59: CAD file, 2023-02-20]
3D модели/Детали step/Емкость/кронштейн wemos.stp
6.00 x 2.50 x 37.0 mm
