delyamio/Avior/3D модели/Детали step/Основание/сосуд.stp

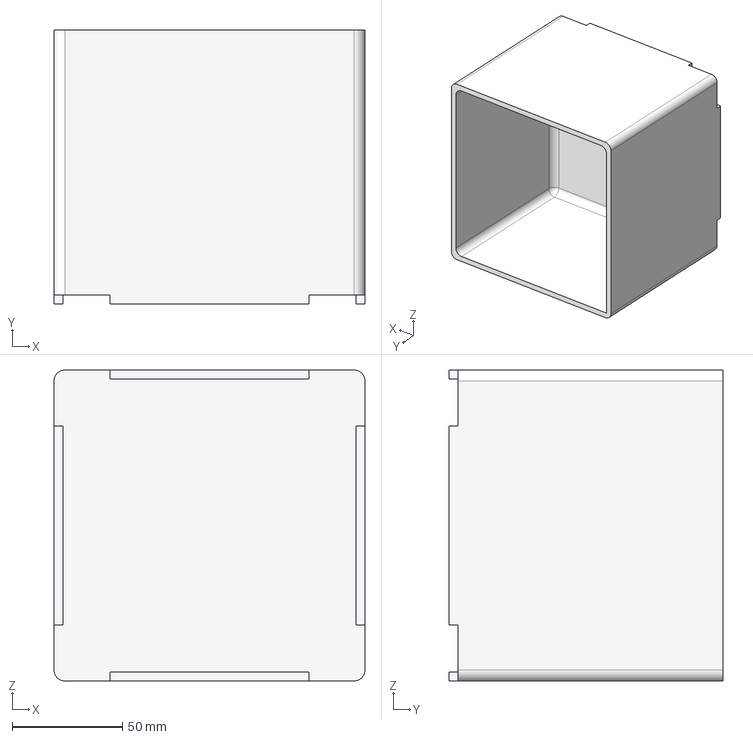
[picture p60: CAD file, 2023-02-20]
3D модели/Детали step/Основание/сосуд.stp
141.0 x 124.0 x 141.0 mm
