delyamio/Avior/3D модели/Детали step/Емкость/столбики.stp

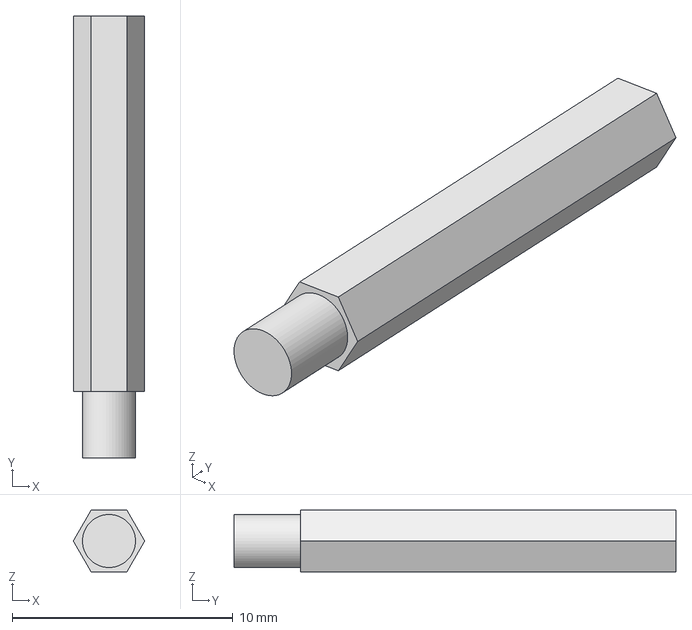
[picture p61: CAD file, 2023-02-20]
3D модели/Детали step/Емкость/столбики.stp
3.23 x 20.0 x 2.80 mm
