delyamio/Avior/3D модели/Детали step/Основание/стенка 4.stp

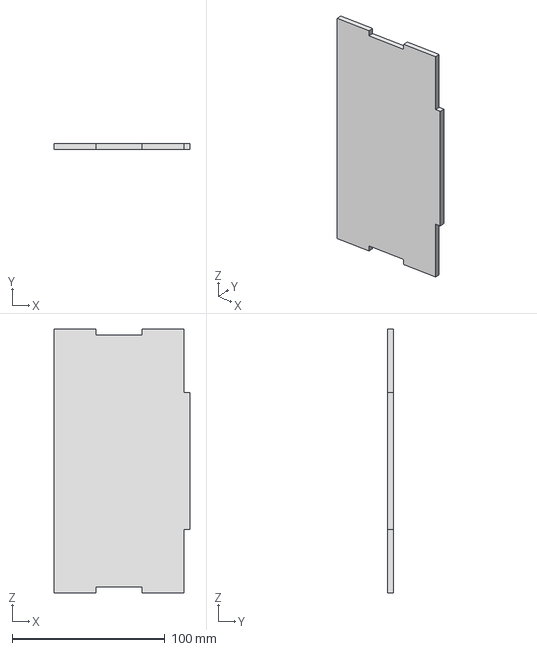
[picture p62: CAD file, 2023-02-20]
3D модели/Детали step/Основание/стенка 4.stp
89.0 x 4.00 x 173.0 mm
