delyamio/Avior/3D модели/Детали step/Форточка/основание форточки.stp

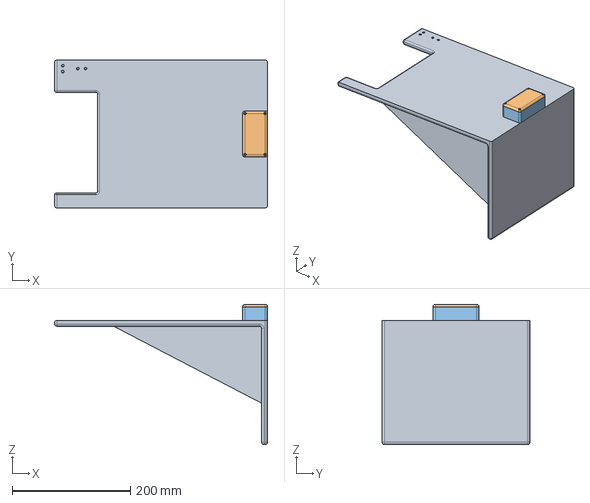
[picture p63: CAD file, 2023-02-20]
3D модели/Детали step/Форточка/основание форточки.stp
360.0 x 250.0 x 237.0 mm
