delyamio/Avior/3D модели/Детали step/Емкость/держатель.stp

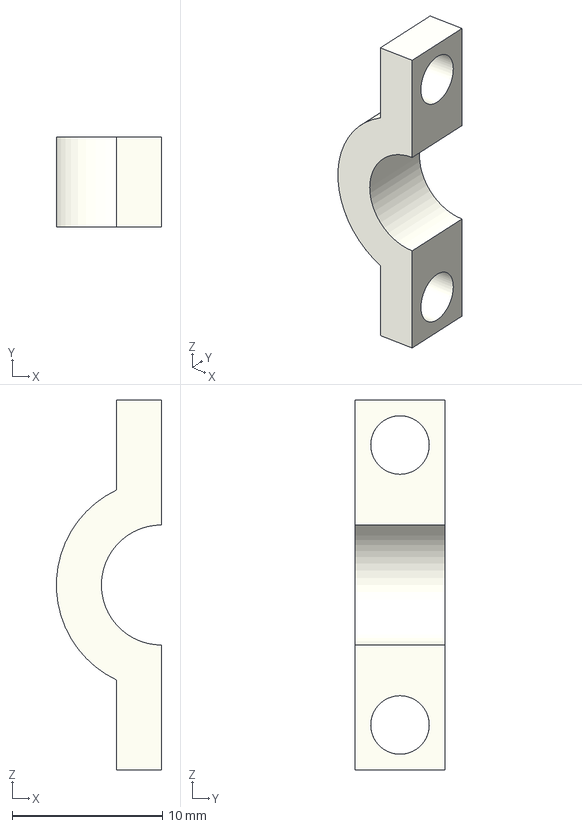
[picture p64: CAD file, 2023-02-20]
3D модели/Детали step/Емкость/держатель.stp
6.99 x 6.00 x 24.6 mm
