delyamio/Avior/3D модели/Детали step/Форточка/коробка сервак.stp

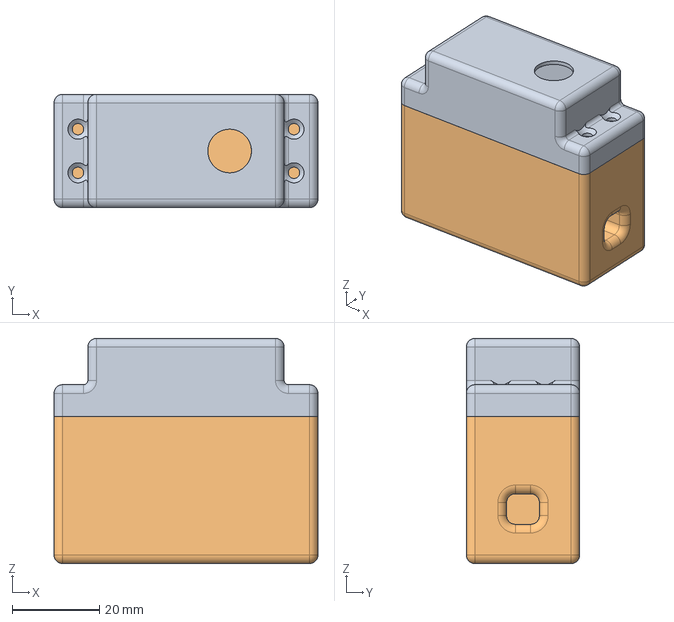
[picture p65: CAD file, 2023-02-20]
3D модели/Детали step/Форточка/коробка сервак.stp
60.5 x 26.0 x 51.6 mm
