delyamio/Avior/3D модели/Детали step/Емкость/змея.stp

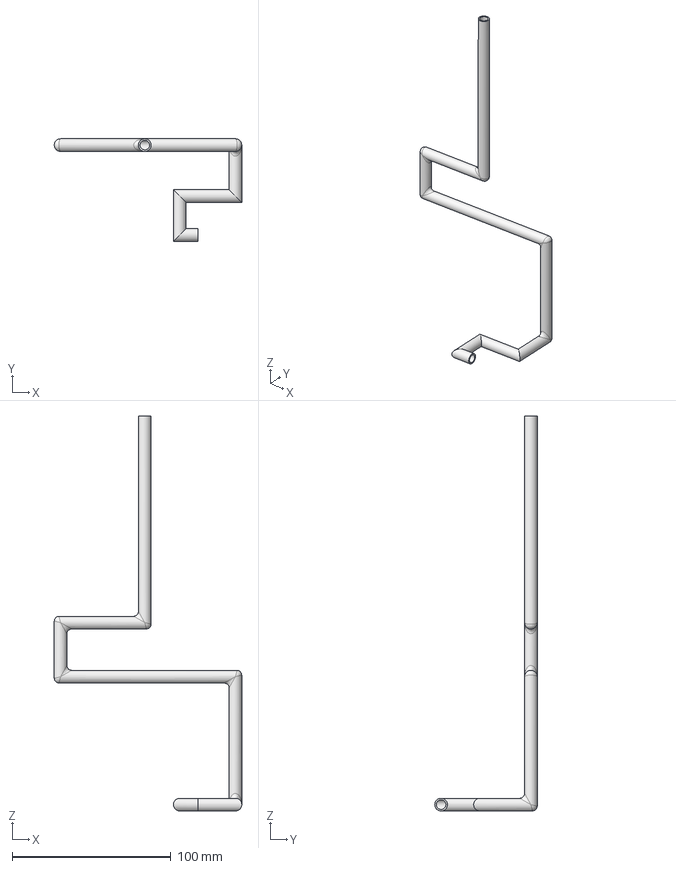
[picture p66: CAD file, 2023-02-20]
3D модели/Детали step/Емкость/змея.stp
118.0 x 64.5 x 248.5 mm
