delyamio/Avior/3D модели/Детали step/Форточка/вал форточка.stp

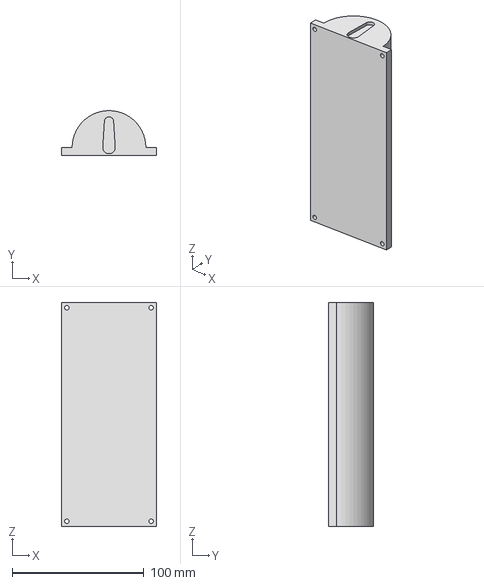
[picture p67: CAD file, 2023-02-20]
3D модели/Детали step/Форточка/вал форточка.stp
72.0 x 34.0 x 170.0 mm
