delyamio/Avior/3D модели/Детали step/Емкость/корпус емкость.stp

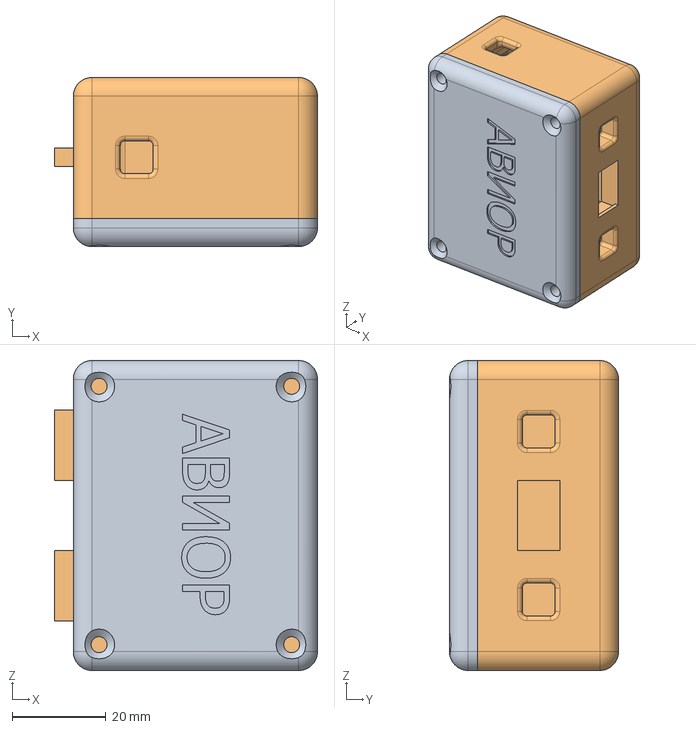
[picture p68: CAD file, 2023-02-20]
3D модели/Детали step/Емкость/корпус емкость.stp
56.0 x 36.0 x 66.0 mm
