delyamio/Avior/3D модели/Детали step/Емкость/насос.stp

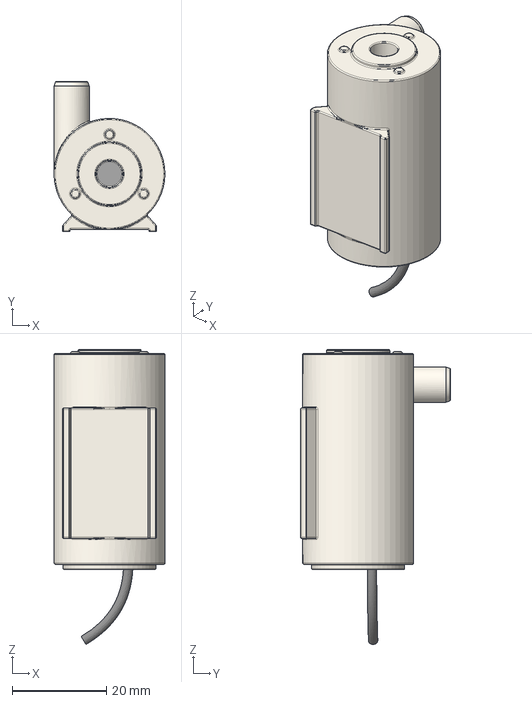
[picture p69: CAD file, 2023-02-20]
3D модели/Детали step/Емкость/насос.stp
23.6 x 32.0 x 62.8 mm
