delyamio/Avior/3D модели/Детали step/Емкость/соединитель 1.stp

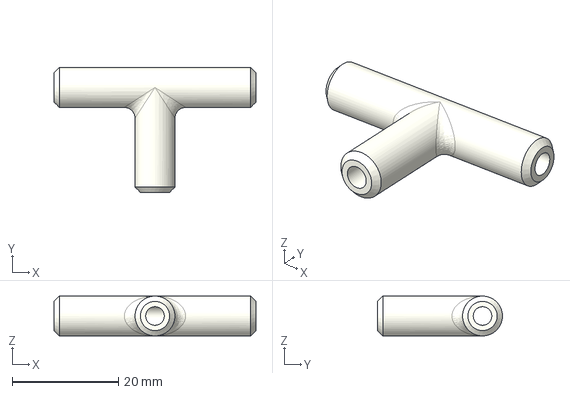
[picture p70: CAD file, 2023-02-20]
3D модели/Детали step/Емкость/соединитель 1.stp
38.0 x 23.5 x 7.50 mm
