delyamio/Avior/3D модели/Детали step/Емкость/труба 2.stp

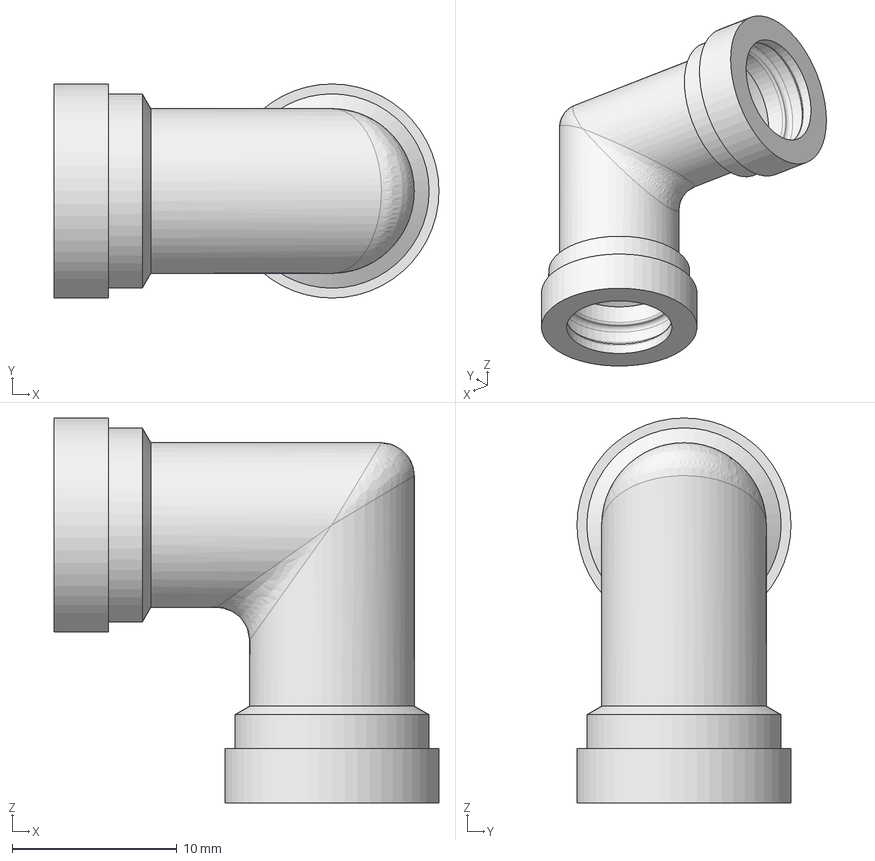
[picture p71: CAD file, 2023-02-20]
3D модели/Детали step/Емкость/труба 2.stp
23.4 x 13.0 x 23.4 mm
