delyamio/Avior/(list of files, cad)

Other CAD files:
3D модели/чертежи/Деталей dxf/крышка корпус.dwg
3D модели/чертежи/Сборочный dxf/финальная сборка.dwg
3D модели/чертежи/Деталей dxf/соединитель 2.dwg
3D модели/чертежи/Сборочный dxf/сборка основание.dwg
3D модели/чертежи/Деталей dxf/корпус дисплей.dwg
3D модели/чертежи/Сборочный dxf/новая форточка.dwg
3D модели/чертежи/Деталей dxf/УвлажнительНовый.dwg
3D модели/чертежи/Сборочный dxf/компановка новая-1.dwg
3D модели/чертежи/Деталей dxf/основание форточки.dwg
3D модели/Детали step/Форточка/servo arm.stp
3D модели/чертежи/Деталей dxf/корпус емкость.dwg
3D модели/чертежи/Деталей dxf/стенки.dwg
3D модели/чертежи/Деталей dxf/сосуд.dwg
3D модели/чертежи/Деталей dxf/корпус-1.dwg
3D модели/чертежи/Деталей dxf/вал форточка.dwg
3D модели/чертежи/Деталей dxf/основание-1.dwg
3D модели/Детали ipt/grabcad/Capacative Soil Moisture Sensor.ipt
3D модели/Детали ipt/grabcad/DC DC.ipt
3D модели/Детали ipt/grabcad/DHT11.ipt
3D модели/Детали ipt/grabcad/Li-po.ipt
3D модели/Детали ipt/grabcad/Switch on off.ipt
3D модели/Детали ipt/grabcad/Water Level Sensor.ipt
3D модели/Детали ipt/grabcad/raspberry pi 4.ipt
3D модели/Детали ipt/grabcad/конденсатор.ipt
3D модели/Детали ipt/grabcad/реле.ipt
3D модели/Детали ipt/Датчики воздух почва/DHT11.ipt
3D модели/Детали ipt/Датчики воздух почва/Кронштейн АКБ.ipt
3D модели/Детали ipt/Датчики воздух почва/Кронштейн МК.ipt
3D модели/Детали ipt/Датчики воздух почва/Пластина.ipt
3D модели/Детали ipt/Датчики воздух почва/корпус.ipt
3D модели/Детали ipt/Датчики воздух почва/крышка корпус.ipt
3D модели/Детали ipt/Дисплей/корпус.ipt
3D модели/Детали ipt/Емкость/УвлажнительНовый.ipt
3D модели/Детали ipt/Емкость/держатель.ipt
3D модели/Детали ipt/Емкость/змея.ipt
3D модели/Детали ipt/Емкость/корпус емкость.ipt
3D модели/Детали ipt/Емкость/кронштейн wemos.ipt
3D модели/Детали ipt/Емкость/насос.ipt
3D модели/Детали ipt/Емкость/соединитель 1.ipt
3D модели/Детали ipt/Емкость/соединитель 2.ipt
3D модели/Детали ipt/Емкость/столбики.ipt
3D модели/Детали ipt/Емкость/труба 2.ipt
3D модели/Детали ipt/Емкость/труба 3.ipt
3D модели/Детали ipt/Емкость/шланг боковой.ipt
3D модели/Детали ipt/Емкость/шланг передний.ipt
3D модели/Детали ipt/Основание/основание.ipt
3D модели/Детали ipt/Основание/сосуд.ipt
3D модели/Детали ipt/Основание/стенка 1.ipt
3D модели/Детали ipt/Основание/стенка 2.ipt
3D модели/Детали ipt/Основание/стенка 3.ipt
3D модели/Детали ipt/Основание/стенка 4.ipt
3D модели/Детали ipt/Основание/стенка боковая.ipt
3D модели/Детали ipt/Форточка/servo arm.ipt
3D модели/Детали ipt/Форточка/вал форточка.ipt
3D модели/Детали ipt/Форточка/коробка сервак.ipt
3D модели/Детали ipt/Форточка/корпус подшипник.ipt
3D модели/Детали ipt/Форточка/кронштейн.ipt
3D модели/Детали ipt/Форточка/основание форточки.ipt
3D модели/Детали ipt/Форточка/подшипник.ipt
3D модели/Детали ipt/Форточка/сервопривод.ipt
3D модели/Детали ipt/Форточка/форточка.ipt
3D модели/Детали step/grabcad/Capacative Soil Moisture Sensor.stp
3D модели/Детали step/grabcad/DC DC.stp
3D модели/Детали step/grabcad/DHT11.stp
3D модели/Детали step/grabcad/Li-po.stp
3D модели/Детали step/grabcad/Switch on off.stp
3D модели/Детали step/grabcad/Water Level Sensor.stp
3D модели/Детали step/grabcad/raspberry pi 4.stp
3D модели/Детали step/grabcad/конденсатор.stp
3D модели/Детали step/grabcad/реле.stp
3D модели/Детали stl/grabcad/Capacative Soil Moisture Sensor.stl
3D модели/Детали stl/grabcad/DC DC.stl
3D модели/Детали stl/grabcad/DHT11.stl
3D модели/Детали stl/grabcad/Li-po.stl
3D модели/Детали stl/grabcad/Switch on off.stl
3D модели/Детали stl/grabcad/Water Level Sensor.stl
3D модели/Детали stl/grabcad/Wemos_D1_mini.stl
3D модели/Детали stl/grabcad/raspberry pi 4.stl
3D модели/Детали stl/grabcad/конденсатор.stl
3D модели/Детали stl/grabcad/реле.stl
3D модели/Детали stl/Датчики воздух почва/DHT11.stl
3D модели/Детали stl/Датчики воздух почва/Кронштейн АКБ.stl
3D модели/Детали stl/Датчики воздух почва/Кронштейн МК.stl
3D модели/Детали stl/Датчики воздух почва/Пластина.stl
3D модели/Детали stl/Датчики воздух почва/корпус.stl
3D модели/Детали stl/Датчики воздух почва/крышка корпус.stl
3D модели/Детали stl/Дисплей/корпус.stl
3D модели/Детали stl/Емкость/УвлажнительНовый.stl
3D модели/Детали stl/Емкость/держатель.stl
3D модели/Детали stl/Емкость/змея.stl
3D модели/Детали stl/Емкость/корпус емкость.stl
3D модели/Детали stl/Емкость/кронштейн wemos.stl
3D модели/Детали stl/Емкость/насос.stl
3D модели/Детали stl/Емкость/соединитель 1.stl
3D модели/Детали stl/Емкость/соединитель 2.stl
3D модели/Детали stl/Емкость/столбики.stl
3D модели/Детали stl/Емкость/труба 2.stl
3D модели/Детали stl/Емкость/труба 3.stl
3D модели/Детали stl/Емкость/шланг боковой.stl
3D модели/Детали stl/Емкость/шланг передний.stl
3D модели/Детали stl/Основание/основание.stl
3D модели/Детали stl/Основание/сосуд.stl
3D модели/Детали stl/Основание/стенка 1.stl
3D модели/Детали stl/Основание/стенка 2.stl
3D модели/Детали stl/Основание/стенка 3.stl
3D модели/Детали stl/Основание/стенка 4.stl
3D модели/Детали stl/Основание/стенка боковая.stl
3D модели/Детали stl/Форточка/servo arm.stl
3D модели/Детали stl/Форточка/вал форточка.stl
3D модели/Детали stl/Форточка/коробка сервак.stl
3D модели/Детали stl/Форточка/корпус подшипник.stl
3D модели/Детали stl/Форточка/кронштейн.stl
3D модели/Детали stl/Форточка/основание форточки.stl
3D модели/Детали stl/Форточка/подшипник.stl
3D модели/Детали stl/Форточка/сервопривод.stl
3D модели/Детали stl/Форточка/форточка.stl
3D модели/Сборки iam/grabcad/TP4056_Charging_Module_Type_C.iam
3D модели/Сборки iam/grabcad/Датчик тока acs712.iam
3D модели/Сборки iam/Датчики воздух почва/Компоновка.iam
3D модели/Сборки iam/Датчики воздух почва/компановка новая.iam
3D модели/Сборки iam/Дисплей/дисплей.iam
3D модели/Сборки iam/Емкость/компановка емкость.iam
3D модели/Сборки iam/Основание/сборка основание.iam
3D модели/Сборки iam/Форточка/коробка + сервак.iam
3D модели/Сборки iam/Форточка/новая форточка.iam
3D модели/Сборки step/grabcad/Датчик тока acs712.stp
3D модели/фин сборка/финальная сборка.iam
3D модели/чертежи/Деталей dxf/OldVersions/УвлажнительНовый.0001.dwg
3D модели/чертежи/Деталей dxf/OldVersions/вал форточка.0001.dwg
3D модели/чертежи/Деталей dxf/OldVersions/корпус дисплей.0002.dwg
3D модели/чертежи/Деталей dxf/OldVersions/корпус емкость.0001.dwg
3D модели/чертежи/Деталей dxf/OldVersions/корпус-1.0002.dwg
3D модели/чертежи/Деталей dxf/OldVersions/крышка корпус.0001.dwg
3D модели/чертежи/Деталей dxf/OldVersions/основание форточки.0001.dwg
3D модели/чертежи/Деталей dxf/OldVersions/основание-1.0001.dwg
3D модели/чертежи/Деталей dxf/OldVersions/соединитель 2.0001.dwg
3D модели/чертежи/Деталей dxf/OldVersions/сосуд.0001.dwg
3D модели/чертежи/Деталей dxf/OldVersions/стенки.0001.dwg
3D модели/чертежи/Сборочный dxf/OldVersions/новая форточка.0001.dwg
3D модели/чертежи/Сборочный dxf/OldVersions/сборка основание.0001.dwg
3D модели/чертежи/Сборочный dxf/OldVersions/финальная сборка.0001.dwg
