delyamio/Avior/Алгоритм/блок-схема.drawio.pdf

#define NO_CONNECTION_STATE 0 #define WAITING_STATE 1 #define SENSOR_ANALISYS_STATE 2 #define CHECK_WATER_STATE 3 #define WATERING_ON_STATE 4 #define ERROR_STATE 5; Глобальные переменные:; void loop(); noConSt_handler(); waitSt_handler(cmd); senAnSt_handler(cmd); chWtSt_handler(cmd); NO_CONNECTION_STATE; WAITING_STATE; SENSOR_ANALISYS_STATE; CHECK_WATER_STATE; Для полива системы; errorSt_handler()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

MST - влажность почвы
CRT - идеальная / совпадает с заданной
WTR - вода / полив

int state - хранит в себе реальные показатели датчиков

когда недостаточно воды в

void chWtSt_handler(); bool waterLevel = checkWaterLevel();; waterLevel; waterring_start_time = millis();; state = WATERING_ON_STATE;; state = ERROR_STATE;; Watering userWatering; int get_command();; return;; int cmd = (int_topic_time); waterringTimeoutInSec = in_topic_time;; waterringTimeoutInSec = 10;

uint32_t waterring_start_time; // Глобальная переменная хранит время запуска насоса

прописываем подкл
к mesh и считываем
запрос на смену
времени полива

#define MSEC_IN_SEC 1000 int waterringTimeoutInSec = 10;; #define WTR_OFF_CMD '5'; cmd == WTR_OFF_CMD; pump_turn_off();; state = WAITING_STATE;; bool waterLevel = checkWaterLevel();; ! waterLevel; Нет; state = ERROR_STATE;; uint32_t now = millis();; abs(now - waterring_start_time) >= waterringTimeoutInSec*MSEC_IN_SEC; return;; pump_turn_on();; digitalWrite(PUMP_PIN, 0);; digitalWrite(PUMP_PIN, 1);

void wtOnSt_handler(int cmd)

void loop; #define NO_CON_STATE 7 #define DVC_ACTIVE_STATE 8 #define READ_STATE 9 #define BUTTON_STATE 10; Глобальные переменные:; int cmd = get_command();; state; turnOnSt_handler(); readSt_handler(cmd); activeSt_handler(cmd); NO_CONNECTION_ST; dvcAcSt_handler(cmd); DVC_ACTIVE_STATE; READ_ST; ACTIVE_ST; #define CON_CMD '11' #define DISCON_CMD '12' #define GET_CMD '13' #define SEND_SERV_CMD '14' #define SEND_MESH_CMD '15' #define ACTIVE_BUTTON_CMD '16'

int st - хранит в себе реальные показатели датчиков

viod loop(); #define NO_CNCT_STATE 11 #define WAIT_STATE 12 #define SENSOR_TEST_STATE 13 #define AIR_ON_STATE 14 #define ERROR_AIR_STATE 15 #define COUNTING_STATE 16; Глобальные переменные:; int cmd = get_command();; state; noConSt_handler(); waitSt_handler(cmd); senAnSt_handler(cmd); airOnSt_handler(cmd); errorSt_handler(cmd); NO_CNCTN_STATE; WAIT_STATE; SENSOR_TEST_STATE; AIR_ON_STATE; ERROR_AIR_STATE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

TMP - температура
CRT - идеальная / совпадает с заданной

int ste - хранит в себе реальные показатели датчиков

void loop(); int cmd = get_command();; state; NoConectionSt_handler(); wtSt_handler(); senSt_handler(); hmdSt_handler(); startHmdSt_handler(); errSt_handler(); timeHmdSt_handler(); void loop; #define NO_CONECTION_STATE 17 #define WT_STATE 18 #define SENSOR_STATE 19 #define HMD_STATE 20 #define START_HMD_STATE 21 #define ERR_STATE 22 #define TIME_HMD_STATE 23; NO_CONECTION_STATE; WT_STATE; SENSOR_STATE; HMD_STATE; START_HMD_STATE; ERR_STATE; TIME_HMD_STATE; #define CONNECTION_CMD '26'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

int stt - хранит в себе реальные показатели

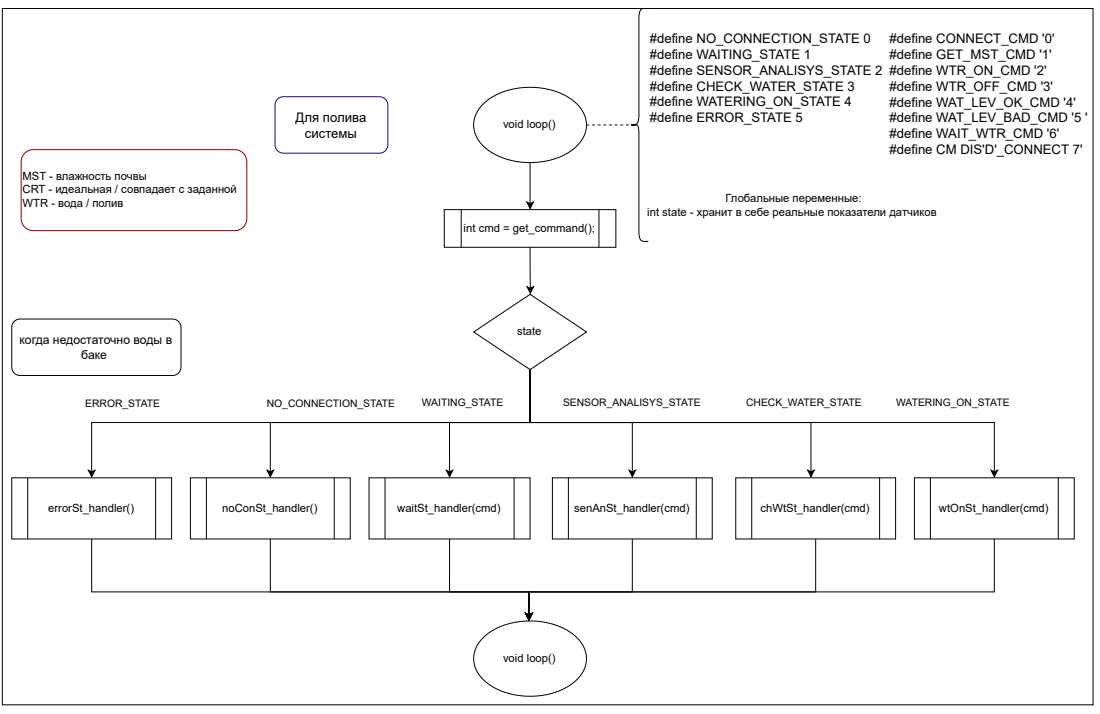
[picture p78: page 8]
void loop(); noConSt_handler(); waitSt_handler(cmd); senAnSt_handler(cmd); chWtSt_handler(cmd); NO_CONNECTION_STATE; WAITING_STATE; SENSOR_ANALISYS_STATE; CHECK_WATER_STATE; Для полива системы; errorSt_handler(); ERROR_STATE; wtOnSt_handler(cmd); int cmd = get_command();; state; WATERING_ON_STATE; баке; #define NO_CONNECTION_STATE 0 #define WAITING_STATE 1 #define SENSOR_ANALISYS_STATE 2 #define CHECK_WATER_STATE 3 #define WATERING_ON_STATE 4 #define ERROR_STATE 5; Глобальные переменные: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

MST - влажность почвы
CRT - идеальная / совпадает с заданной
WTR - вода / полив

int state - хранит в себе реальные показатели датчиков

когда недостаточно воды в

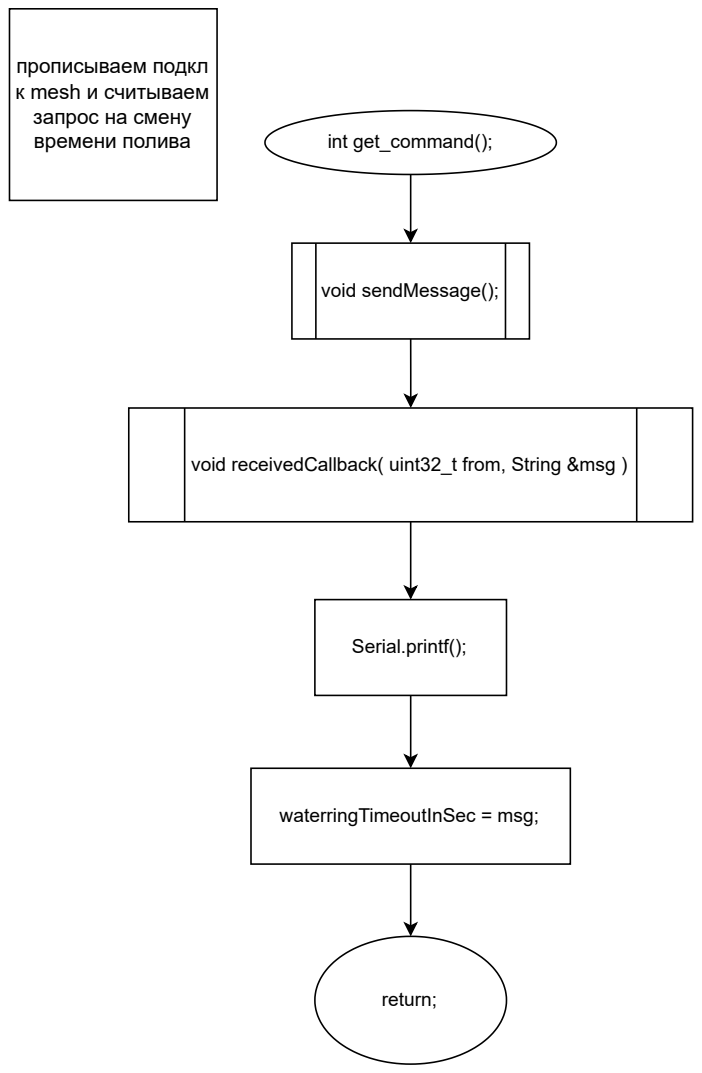
[picture p79: page 9]
int get_command();; void sendMessage();; Serial.printf();; waterringTimeoutInSec = msg;; return;

прописываем подкл
к mesh и считываем
запрос на смену
времени полива

void receivedCallback( uint32_t from, String &msg )
