delyamio/Avior/Алгоритм/State machine.pdf

## система полива

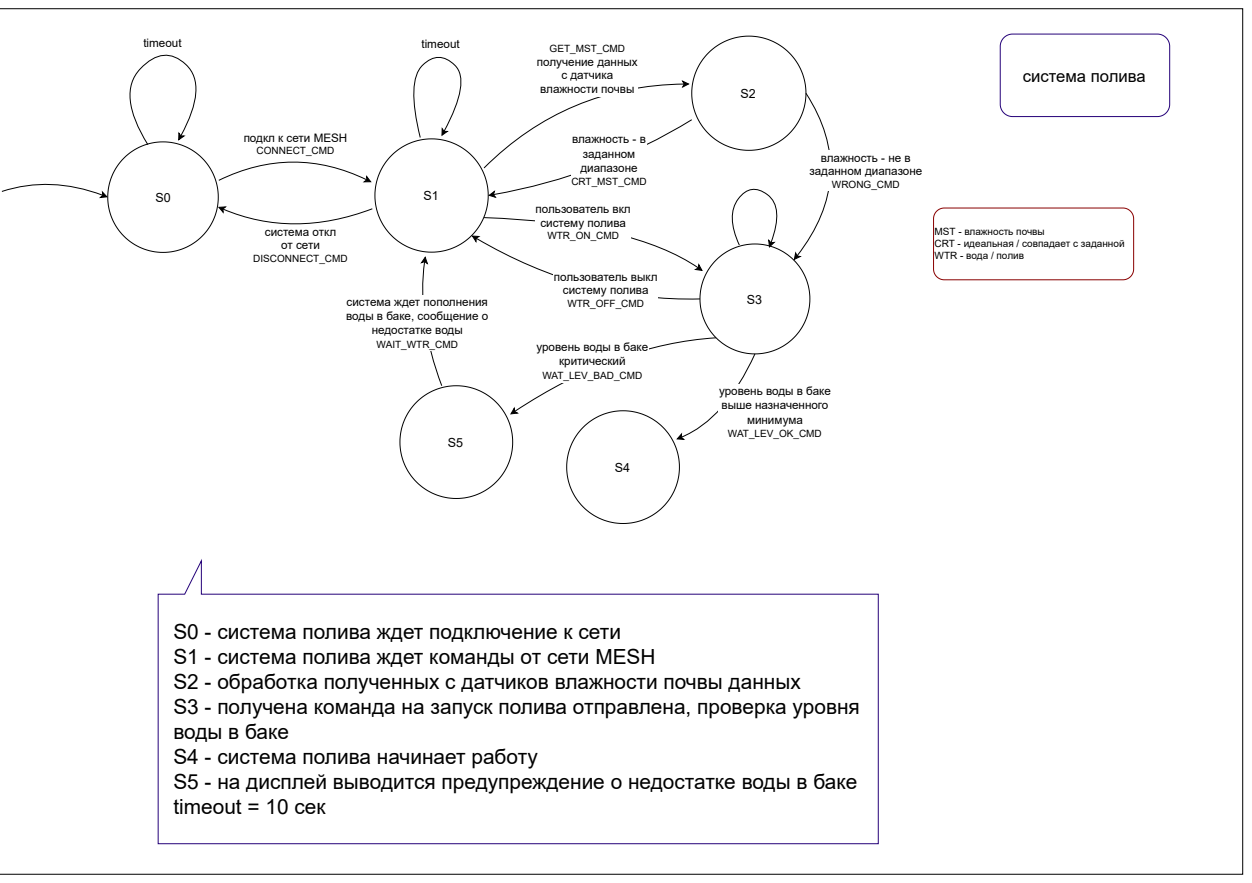
[picture p80: page 2]
влажность - в заданном диапазоне CRT_MST_CMD; влажность - не в заданном диапазоне WRONG_CMD; пользователь вкл систему полива WTR_ON_CMD; пользователь выкл систему полива WTR_OFF_CMD; система откл от сети DISCONNECT_CMD; timeout; GET_MST_CMD; получение данных с датчика влажности почвы; уровень воды в баке критический WAT_LEV_BAD_CMD

подкл к сети MESH
CONNECT_CMD

MST - влажность почвы
CRT - идеальная / совпадает с заданной
WTR - вода / полив

система ждет пополнения
воды в баке, сообщение о
недостатке воды
WAIT_WTR_CMD

уровень воды в баке
выше назначенного
минимума
WAT_LEV_OK_CMD

S0 - система полива ждет подключение к сети
S1 - система полива ждет команды от сети MESH
S2 - обработка полученных с датчиков влажности почвы данных
S3 - получена команда на запуск полива отправлена, проверка уровня
воды в баке
S4 - система полива начинает работу
S5 - на дисплей выводится предупреждение о недостатке воды в баке
timeout = 10 сек

## Агрегирующее устройство-шлюз

## S0 - устройство ждет

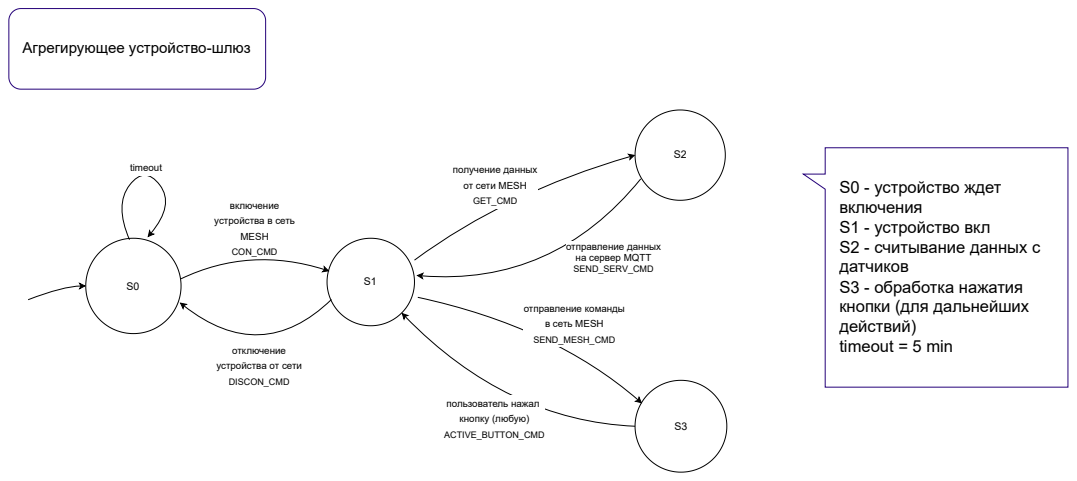
[picture p81: page 3]
включение устройства в сеть MESH; CON_CMD; отключение устройства от сети; DISCON_CMD; отправление команды в сеть MESH; SEND_MESH_CMD; пользователь нажал кнопку (любую); ACTIVE_BUTTON_CMD; timeout

получение данных
от сети MESH
GET_CMD

включения
S1 - устройство вкл
S2 - считывание данных с
датчиков
S3 - обработка нажатия
кнопки (для дальнейших
действий)
timeout = 5 min

отправление данных
на сервер MQTT
SEND_SERV_CMD

## система форточки

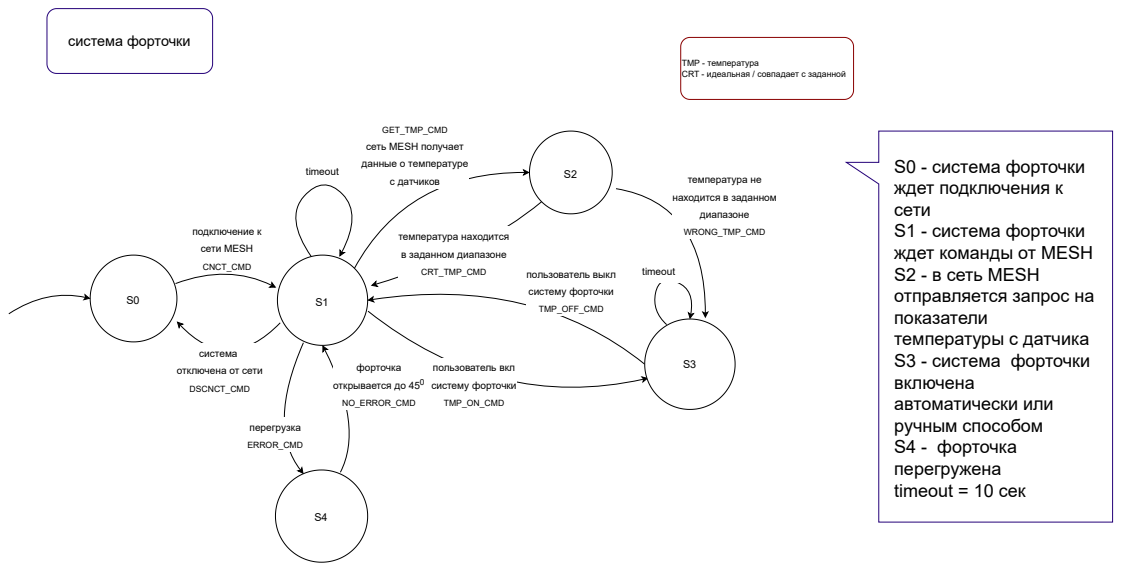
[picture p82: page 4]
подключение к; сети MESH; CNCT_CMD; DSCNCT_CMD; перегрузка; ERROR_CMD; форточка открывается до 45⁰; NO_ERROR_CMD; температура находится; в заданном диапазоне; CRT_TMP_CMD; пользователь выкл; систему форточки; TMP_OFF_CMD; пользователь вкл; TMP_ON_CMD; температура не; находится в заданном; диапазоне; WRONG_TMP_CMD; timeout; S0 - система форточки

TMP - температура
CRT - идеальная / совпадает с заданной

GET_TMP_CMD
сеть MESH получает
данные о температуре
с датчиков

ждет подключения к
сети
S1 - система форточки
ждет команды от MESH
S2 - в сеть MESH
отправляется запрос на
показатели
температуры с датчика
S3 - система форточки
включена
автоматически или
ручным способом
S4 - форточка
перегружена
timeout = 10 сек

система
отключена от сети

## увлажнитель воздуха

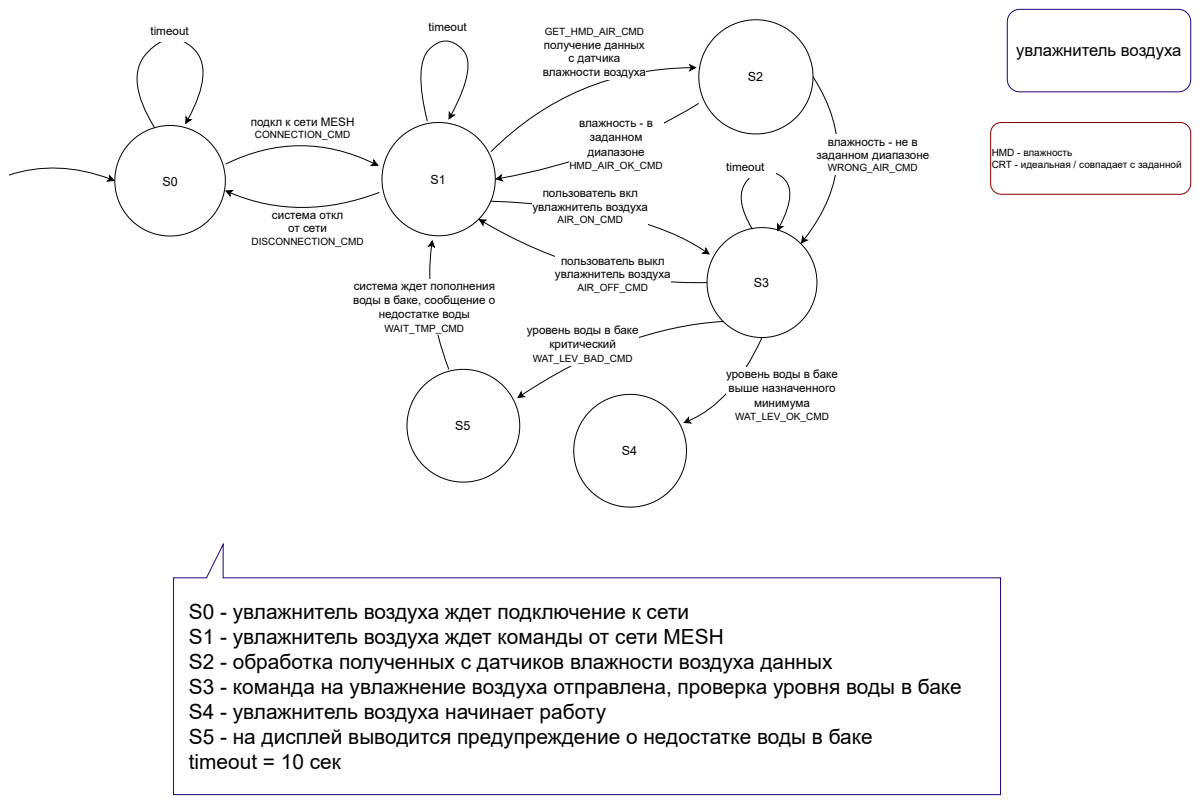
[picture p83: page 5]
влажность - в заданном диапазоне HMD_AIR_OK_CMD; влажность - не в заданном диапазоне WRONG_AIR_CMD; пользователь вкл увлажнитель воздуха AIR_ON_CMD; пользователь выкл увлажнитель воздуха AIR_OFF_CMD; система откл от сети DISCONNECTION_CMD; timeout timeout; GET_HMD_AIR_CMD; получение данных с датчика влажности воздуха; уровень воды в баке критический WAT_LEV_BAD_CMD; HMD - влажность; timeout; CRT - идеальная / совпадает с заданной

подкл к сети MESH
CONNECTION_CMD

система ждет пополнения
воды в баке, сообщение о
недостатке воды
WAIT_TMP_CMD

уровень воды в баке
выше назначенного
минимума
WAT_LEV_OK_CMD

S0 - увлажнитель воздуха ждет подключение к сети
S1 - увлажнитель воздуха ждет команды от сети MESH
S2 - обработка полученных с датчиков влажности воздуха данных
S3 - команда на увлажнение воздуха отправлена, проверка уровня воды в баке
S4 - увлажнитель воздуха начинает работу
S5 - на дисплей выводится предупреждение о недостатке воды в баке
timeout = 10 сек
