delyamio/Avior/Алгоритм/Диаграмма sequence последовательностей.drawio.pdf

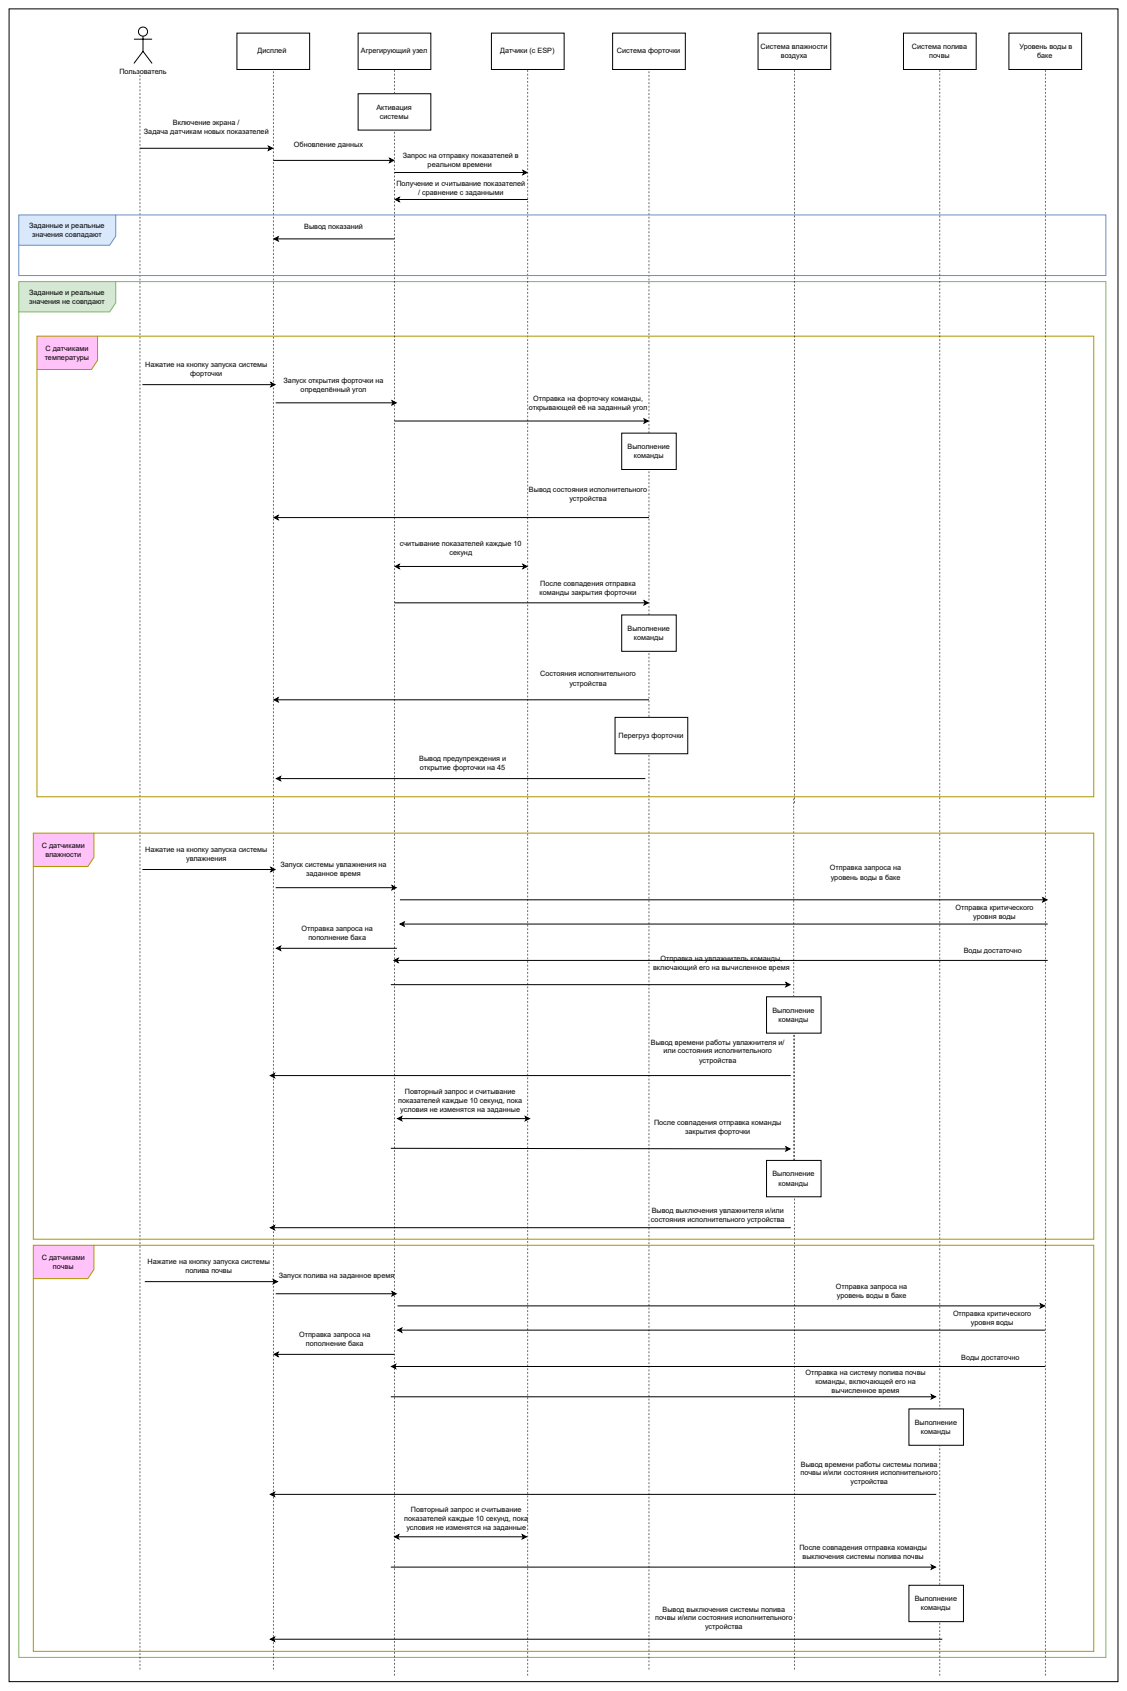
[picture p84: page 1]
Пользователь; Включение экрана /; Агрегирующий узел; Обновление данных; Датчики (с ESP); реальном времени; Система форточки; Вывод показаний; Заданные и реальные значения совпадают; С датчиками температуры; Система влажности воздуха; Состояния исполнительного устройства; Система полива почвы; Активация системы; Дисплей; Выполнение команды; устройства; секунд; форточки; Перегруз форточки; С датчиками влажности; С датчиками почвы; заданное время; увлажнения; полива почвы; Уровень воды в баке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

Задача датчикам новых показателей

Запрос на отправку показателей в

Получение и считывание показателей
/ сравнение с заданными

Заданные и реальные
значения не совпдают

Нажатие на кнопку запуска системы

Запуск открытия форточки на
определённый угол

Отправка на форточку команды,
открывающей её на заданный угол

Вывод состояния исполнительного

считывание показателей каждые 10

После совпадения отправка
команды закрытия форточки

Вывод предупреждения и
открытие форточки на 45

Запуск системы увлажнения на

Отправка запроса на
уровень воды в баке

пополнение бака

Отправка на увлажнитель команды,
включающий его на вычисленное время

Вывод времени работы увлажнителя и/
или состояния исполнительного

Повторный запрос и считывание
показателей каждые 10 секунд, пока
условия не изменятся на заданные

После совпадения отправка команды

Вывод выключения увлажнителя и/или
состояния исполнительного устройства

Запуск полива на заданное время

Отправка на систему полива почвы
команды, включающей его на
вычисленное время

Вывод времени работы системы полива
почвы и/или состояния исполнительного

выключения системы полива почвы

Вывод выключения системы полива
