delyamio/Avior/3D модели/чертежи/Деталей pdf/корпус-1.pdf

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

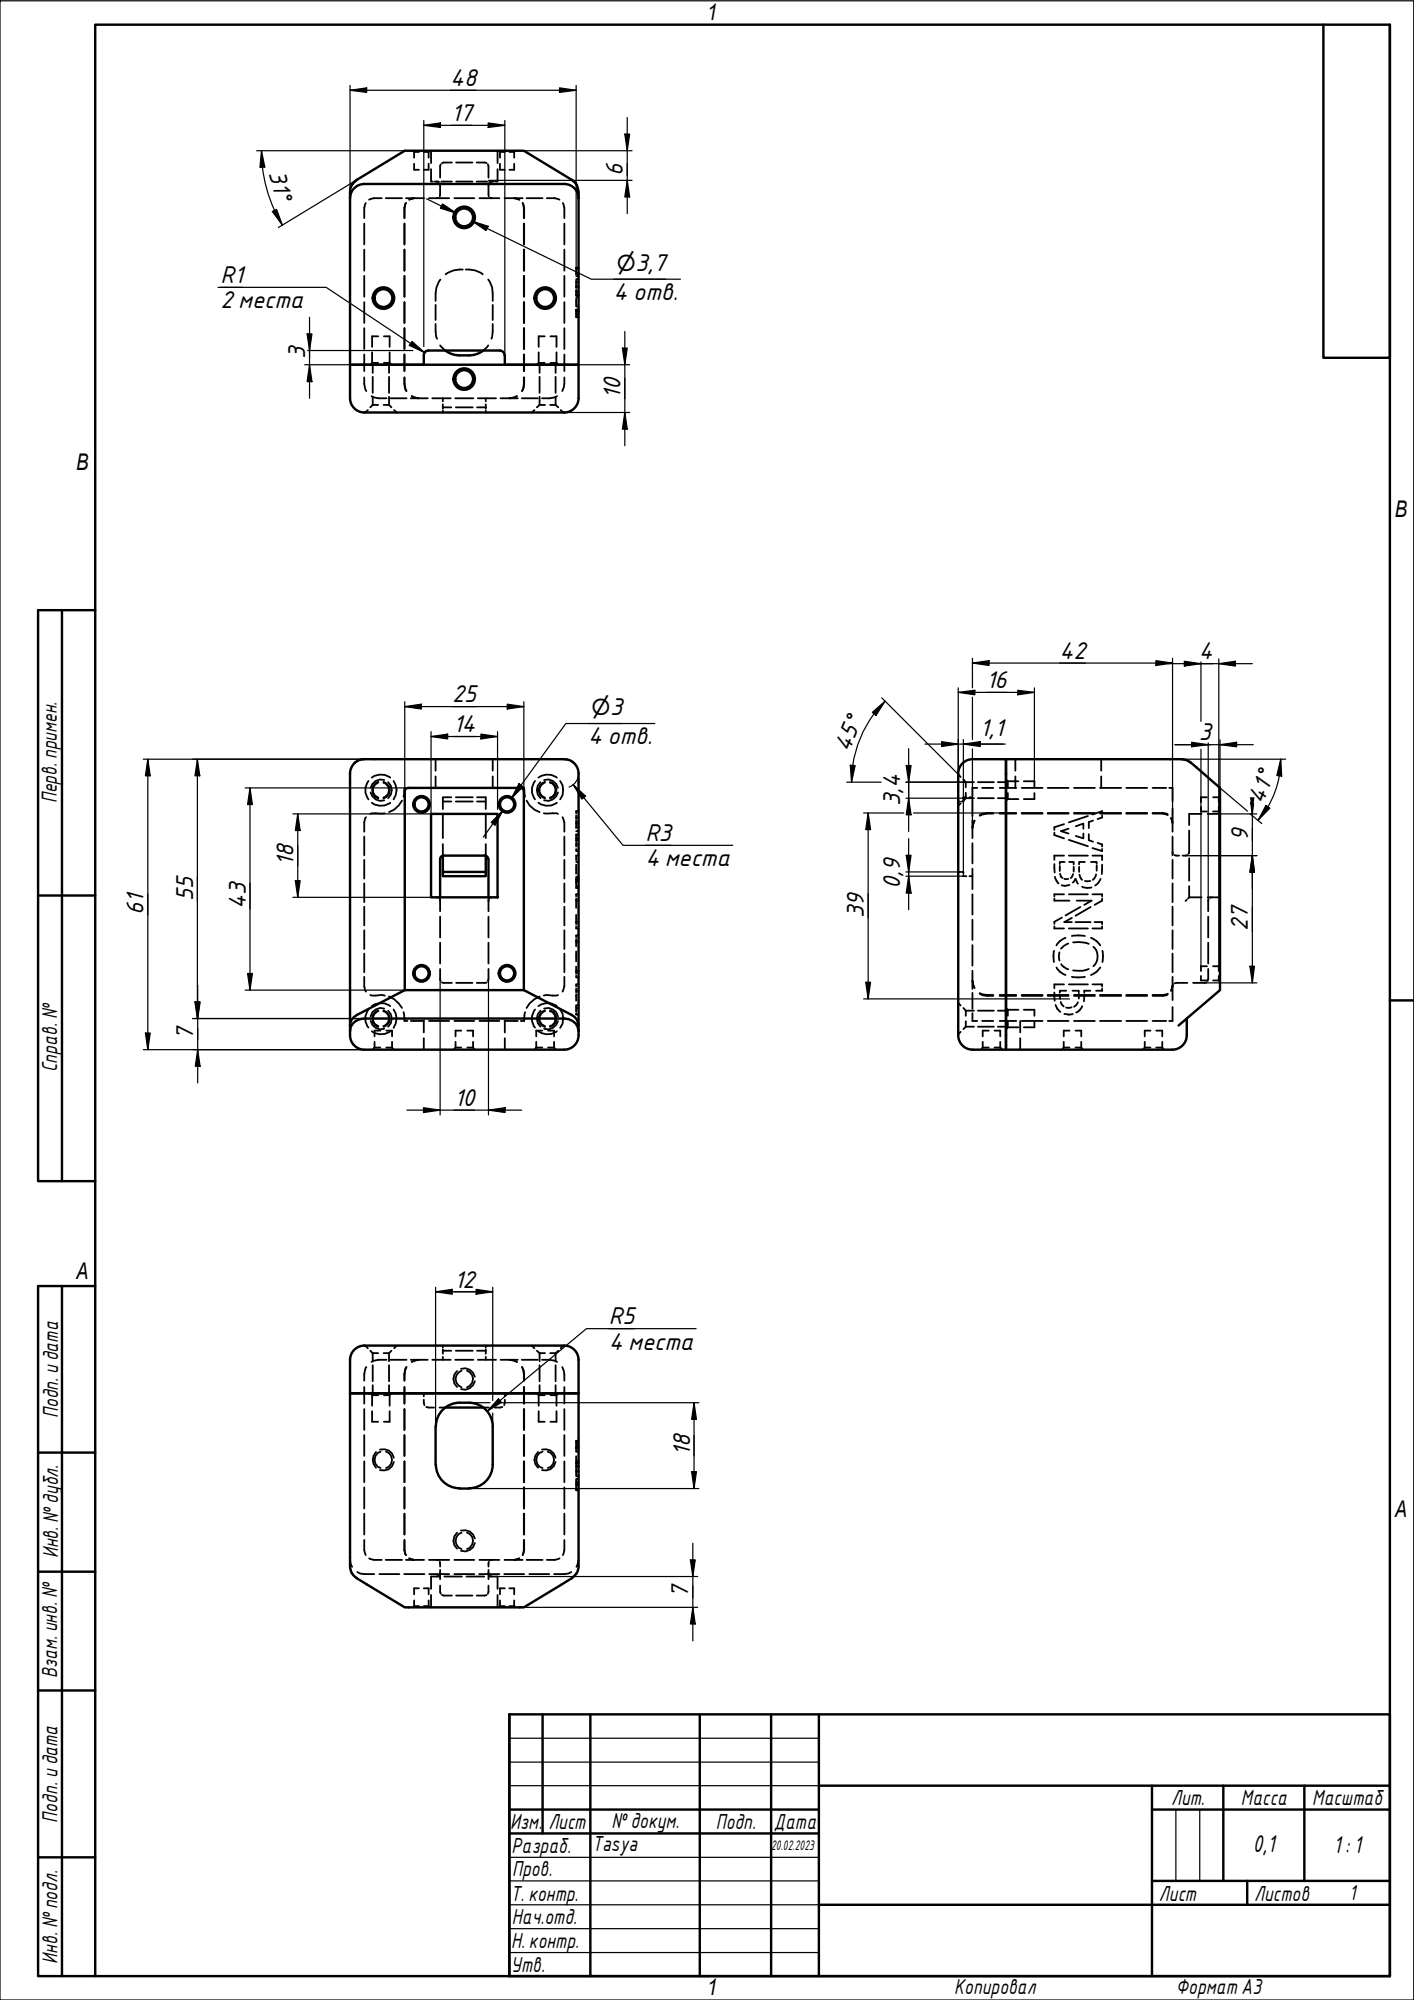
[picture p88: page 1]
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
