delyamio/Avior/3D модели/чертежи/Сборочный pdf/новая форточка.pdf

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

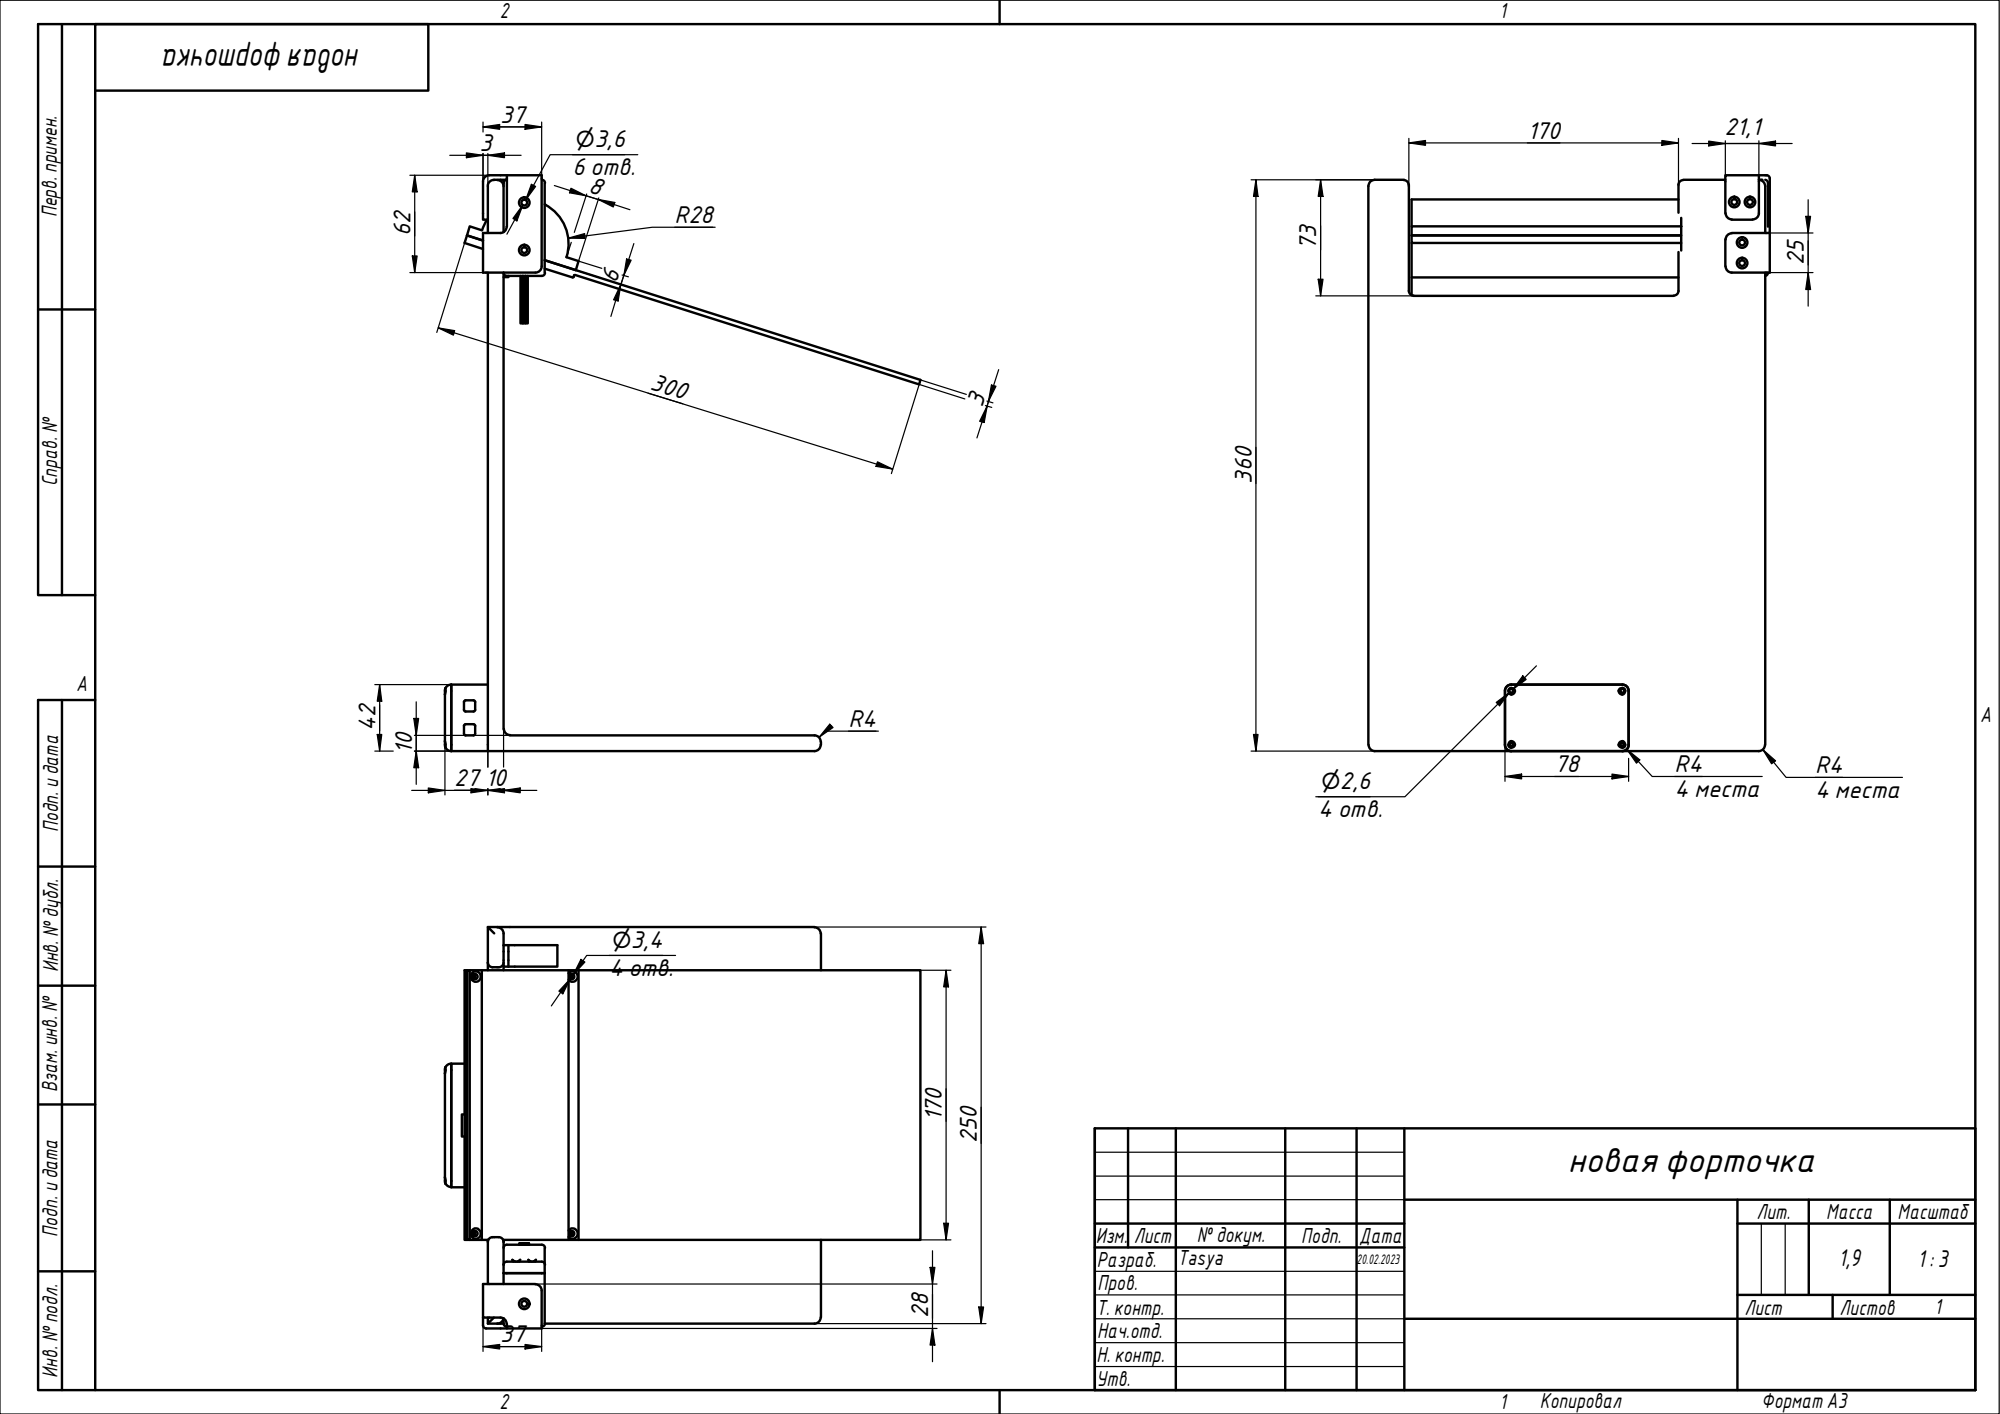
[picture p94: page 1]
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
