delyamio/Avior/(list of files, drawings)

Other design files:
Электроника/tp4056.fzz
Электроника/Механизм для форточки .fzz
Электроника/реле.fzz
Электроника/Система климатических датчиков.fzz
Электроника/Система полива и увлажнения.fzz
Электроника/Узел агрегации.fzz
