delyamio/Avior/(commit log)

2023-02-18 Электроника
    [tp4056.fzz, Механизм для форточки .fzz, Система климатических датчиков.fzz, Система полива и увлажнения.fzz, Узел агрегации.fzz, реле.fzz]
2023-02-18 Электроника в папке
    [tp4056.fzz, Механизм для форточки .fzz, Система климатических датчиков.fzz, Система полива и увлажнения.fzz, Узел агрегации.fzz, реле.fzz]
2023-02-18 Алгоритм
2023-02-18 3D-модели часть 1
    [Capacative Soil Moisture Sensor.ipt, Capacative Soil Moisture Sensor.stp, DC DC.ipt, DC DC.stp, DHT11.ipt, DHT11.stp, Li-po.ipt, Li-po.stp]
2023-02-18 3D модели часть 2
    [Capacative Soil Moisture Sensor.stl, DC DC.stl, DHT11.stl, Li-po.stl, Switch on off.stl, TP4056_Charging_Module_Type_C.iam, Water Level Sensor.stl, Wemos_D1_mini.stl]
2023-02-18 Алгорит - Блок-схемы
2023-02-18 3D модели часть 3
    [коробка + сервак.stp]
2023-02-18 3D модели/Сборки step - часть 4
2023-02-19 Рендеринг
2023-02-19 Компановка
    [компановка новая-1 (2).dwg]
2023-02-20 чертежи
    [УвлажнительНовый.0001.dwg, УвлажнительНовый.dwg, вал форточка.0001.dwg, вал форточка.dwg, компановка новая-1.dwg, корпус дисплей.0002.dwg, корпус дисплей.dwg, корпус емкость.0001.dwg]
2023-02-21 Update финальная версия кода.ino
